imiev-battery-upgrade/imiev-battery-upgrade/cmu/README.md

A cell monitoring unit (CMU) monitors the four batteries in a tray.

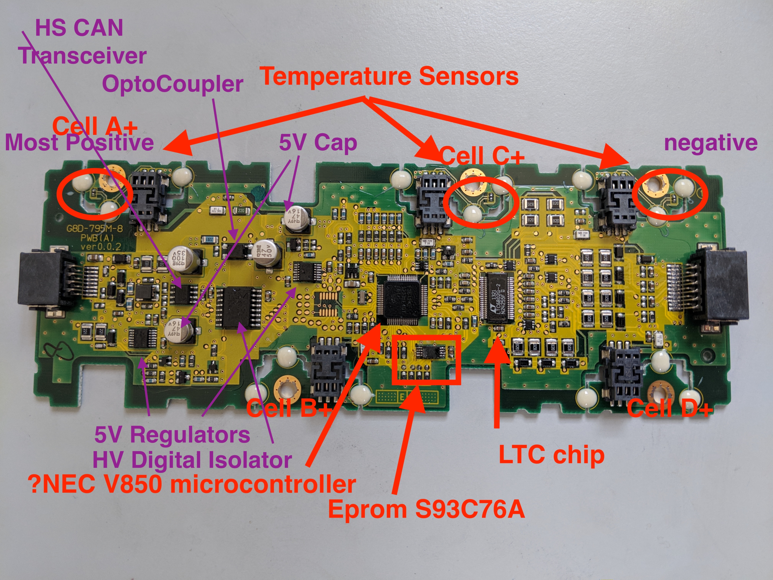
[picture p1: cmu/cmu.jpg]
picture, source: Mário Fernandes (Portugal), through https://www.diyelectriccar.com/threads/mitsubishi-i-miev-cmu-board-notes.200527/
