imiev-battery-upgrade/imiev-battery-upgrade/pack_removal.md

# Pack Removal

The following describes a method to remove and reinstall the i-MiEV's traction battery pack safely and easily without the use of a vehicle lift.

## Procedure

### Vehicle Preparation

1. Lift the vehicle and support it on jack stands.

    See the [SUPPORT LOCATIONS FOR LIFTING AND JACKING](https://web.archive.org/web/20241204221109/http://mmc-manuals.ru/manuals/i-miev/online/Service_Manual/2017/00/html/M100100070122301ENG.HTM) for safe lift and support points.

    In order for the traction battery pack to clear the body, the vehicle must be lifted significantly.

    > [!WARNING]
    > The traction battery pack weighs ~500 pounds. Ensure that the vehicle is well-supported and the jack stands spread widely (both left-right and front-back) so that the car does not shift when removing or installing the pack.

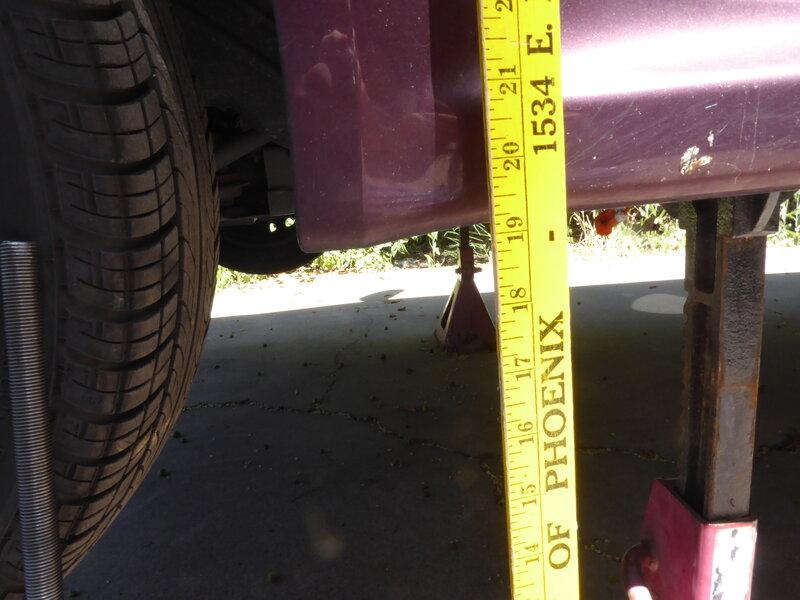
[picture p15: _attachments/P1140324_1751892503863308.JPG]
Vehicle front lifted on jack stands
    

    *Front of vehicle lifted so rocker panel is 19.25" above the ground, which was the limit of the jack stands.*

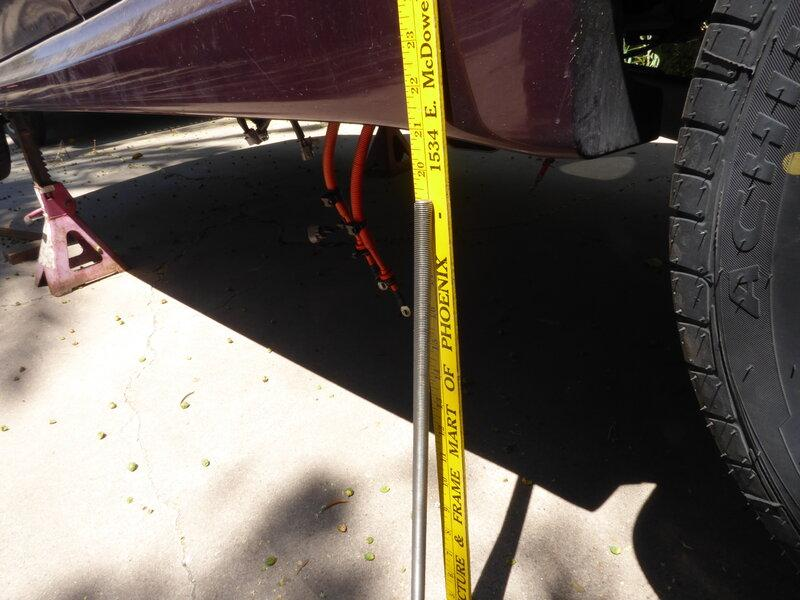
[picture p16: _attachments/P1140330_1751892503868984.JPG]
Vehicle rear lifted on jack stands
    

    *Rear of vehicle lifted so rocker panel is 21" above the ground, which was the limit of the jack stands (supported at rear axle, not shown in photo).*

### Electrical Disconnection

1. Follow the [TRACTION BATTERY REMOVAL AND INSTALLATION](https://web.archive.org/web/20241204221210/http://mmc-manuals.ru/manuals/i-miev/online/Service_Manual/2017/54/html/M154940130021501ENG.HTM) instructions in the service manual to:
    1. Disconnect the 12 volt auxiliary battery.
    2. Disconnect the traction battery pack service plug.
    3. Remove the front and rear traction battery pack splash shields.
    4. Disconnect cables to the traction battery pack.

### Pack Support Installation

1. Remove four of the traction battery pack mounting bolts and replace them with threaded rods and nuts.

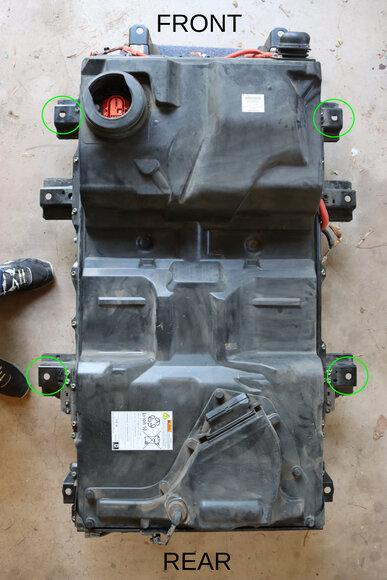
[picture p17: _attachments/pack_bolts_to_remove_1751892503857249.jpg]
Battery pack mounting points
    

    *Remove the four traction battery pack mounting bolts at the circled mount points (shown here from the top with the pack removed).*

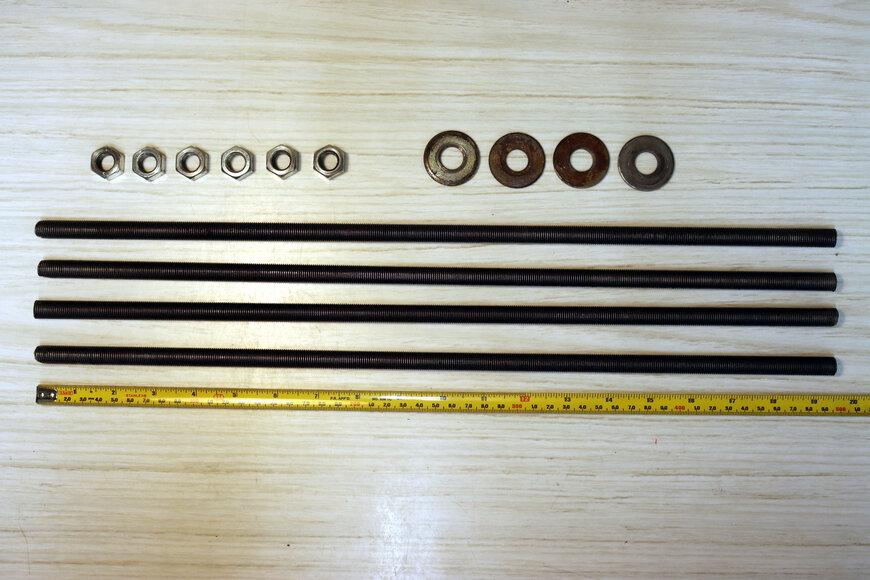
[picture p18: _attachments/threaded_rods_1751892503882977.jpg]
Threaded rods and hardware
    

    *Obtain four [M12-1.25 threaded rods](https://www.clipsandfasteners.com/M12-1-25-x-1-Meter-Threaded-Rod-Class-4-6-Plain-p/bi-v34127.htm) that are approximately 0.5 meters long, a minimum of 6 [M12-1.25 nuts](https://www.clipsandfasteners.com/12mm-1-25-Din-934-Hex-Nut-Zinc-p/a14458.htm), and four fender washers.*

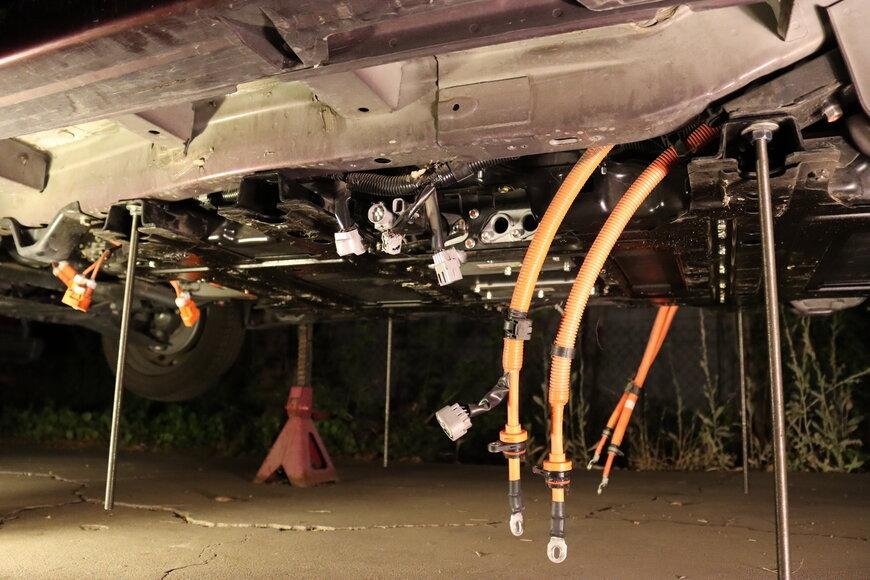
[picture p19: _attachments/IMG_2802_17518925038831842.JPG]
Threaded rod installation
    

    *Replace each of the four removed traction battery pack mounting bolts with a threaded rod, washer, and nut. Ensure the rods are sufficiently threaded into the holes in the body to hold the weight of the pack. Snug the nuts so the threaded rod is supporting the traction battery pack.*

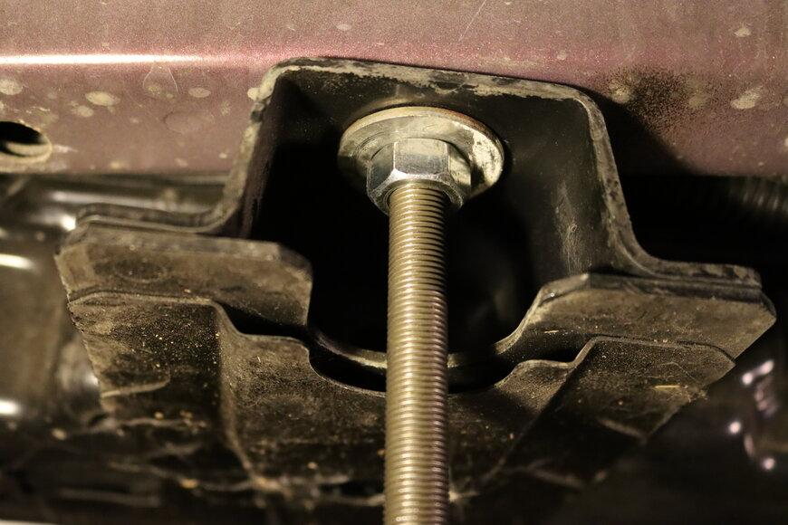
[picture p20: _attachments/IMG_2805_1751892503891283.JPG]
Front mounting point with rod
    

    *Front traction battery pack mounting bolt replaced with threaded rod, washer, and nut.*

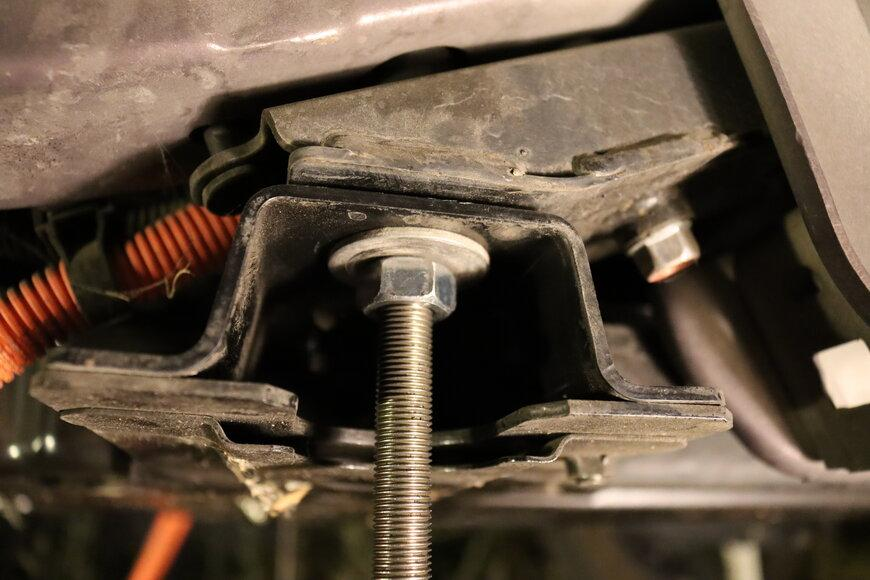
[picture p21: _attachments/IMG_2804_1751892503902833.JPG]
Rear mounting point with rod
    

    *Rear traction battery pack mounting bolt replaced with threaded rod, washer, and nut.*

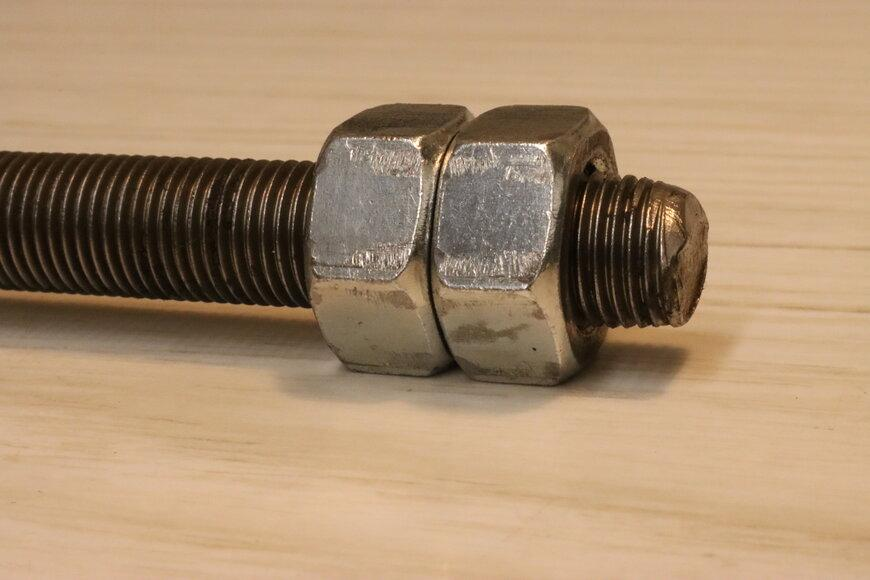
[picture p22: _attachments/IMG_2880_1751892503896538.JPG]
Using locked nuts to install rod
    

    *If the rods can't be hand threaded into the body, two nuts can be locked against each other on the other end of the rod; the locked nuts can then be used to turn the rod into the body with a wrench.*

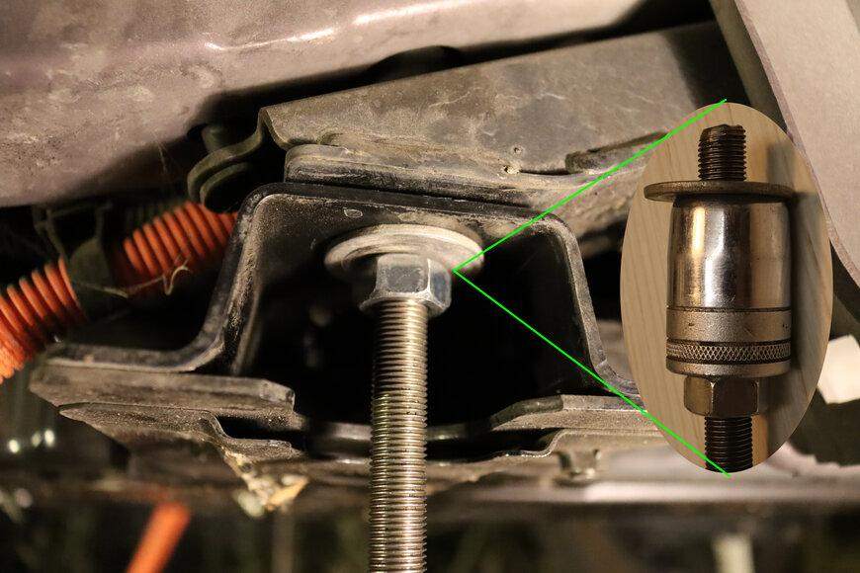
[picture p23: _attachments/spacer_1751892503916682.jpg]
Optional spacer installation
    

    *Optional: Include a spacer between the washer and nut (concept shown in inset using an 1/2 inch drive socket) to move the nut below the box beam. This will make it easier to turn the nut by allowing a wrench to move through a full 360 degrees.*

### Pack Lowering

1. Remove the remaining 6 traction battery pack mounting bolts; the pack will remain in place, supported by the threaded rods and nuts.

2. Lower the pack by loosening the nuts.

    It is recommended to run all four nuts down the rods in small increments to keep the pack approximately level.

    > [!WARNING]
    > Ensure that the rod does not turn and unthread from the body when turning a nut. If the rods can't be held from turning by hand, [lock two nuts](https://5by9.net/prune_batteries/pack_removal.html#lock-two-nuts) against each other and hold with a wrench.

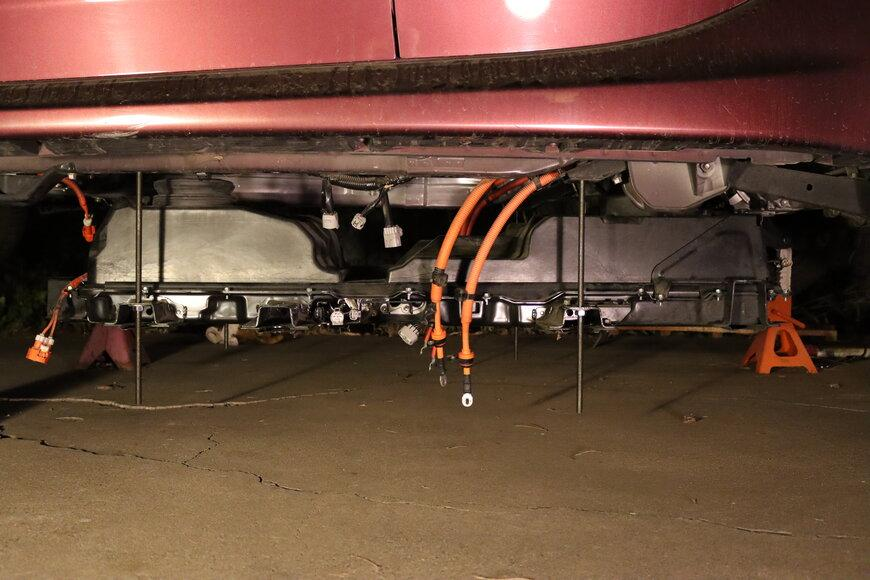
[picture p24: _attachments/IMG_2787_1751892503916571.JPG]
Pack being lowered
    

    *Pack partially lowered. This will be a slow process due to the fine thread on the rods. A ratcheting box wrench is helpful, but still an interference fit with the box beam. If a [spacer was added](https://5by9.net/prune_batteries/pack_removal.html#spacer) in the previous step to lower the nut below the box beam (not shown in photo), a wrench can be turned 360 degrees, which should expedite the process.*

3. Optional: Use a jack to expedite lowering the pack.

    Iteratively supporting the weight of the pack with a jack, spinning down the nuts by hand, and then lowering the pack with the jack to the nuts may be faster.

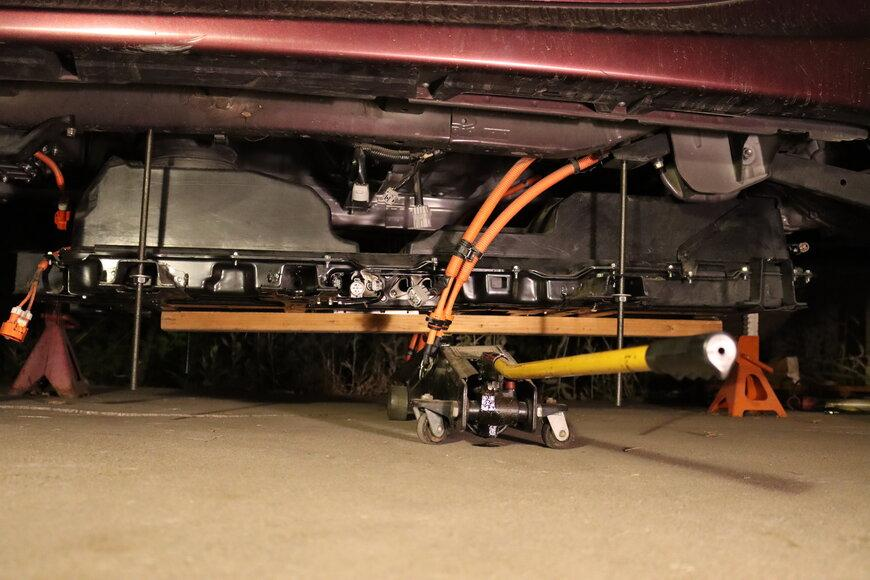
[picture p25: _attachments/IMG_2795_1751892503931233.JPG]
Using jack to assist lowering
    

    *Optional: Use a jack and a 2x4 to slightly lift the pack off the nuts. This allows hand spinning down the nuts, which is much faster than turning the nuts with a wrench under load, while still keeping the descent controlled. It may take several attempts to find the balance point when lifting with the jack (balance point is slightly towards the rear of the pack). Alternatively, multiple jacks can be used to avoid the balancing issue. For a controlled descent, lift the pack off the nuts, spin the nuts down a few inches, lower the pack onto the nuts, and repeat.*

### Final Removal

1. Lower the pack onto dollies.

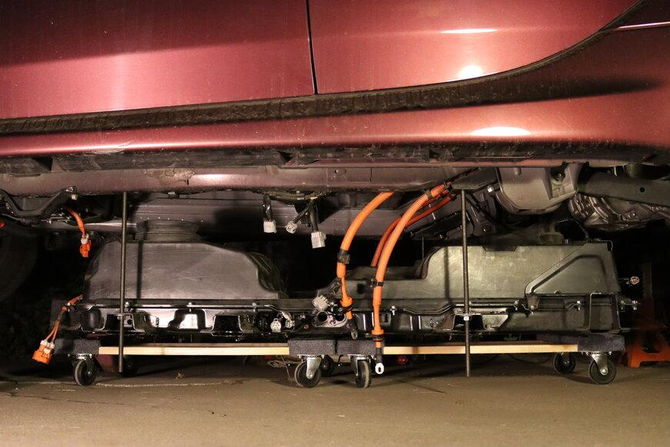
[picture p26: _attachments/IMG_2781_17518925039241128.JPG]
Dollies positioned under pack
    

    *When approaching the height of the dollies, insert them under the pack. Two [Franklin 30 x 18 inch dollies](https://www.harborfreight.com/30-in-x-18-in-1000-lb-capacity-hardwood-dolly-58316.html) were used.*

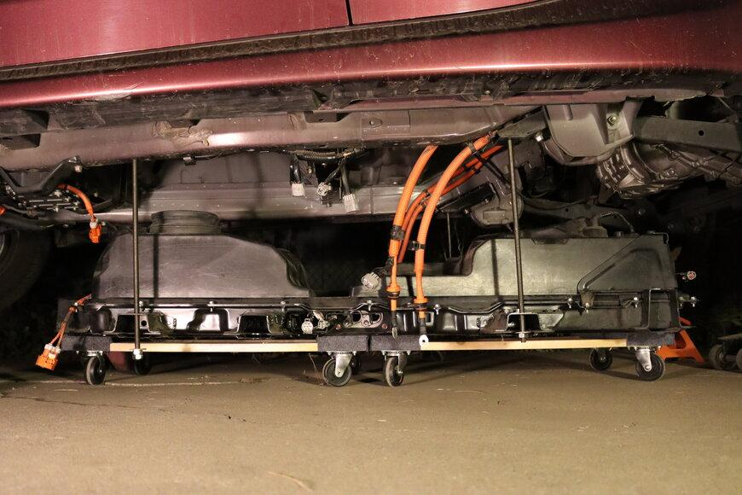
[picture p27: _attachments/IMG_2779_1751892503953265.JPG]
Pack resting on dollies
    

    *Pack resting on dollies. Nuts backed off so the threaded rods are no longer holding any weight.*

2. Remove the rods from the body.

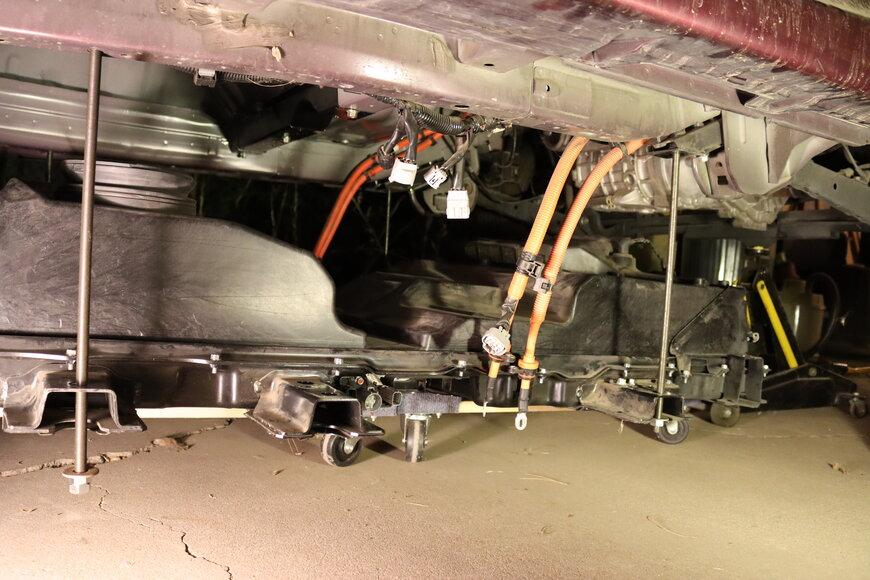
[picture p28: _attachments/IMG_2774_175189250395986.JPG]
Removing rods from body
    

    *Unscrew the rods from the body once they are no longer holding weight.*

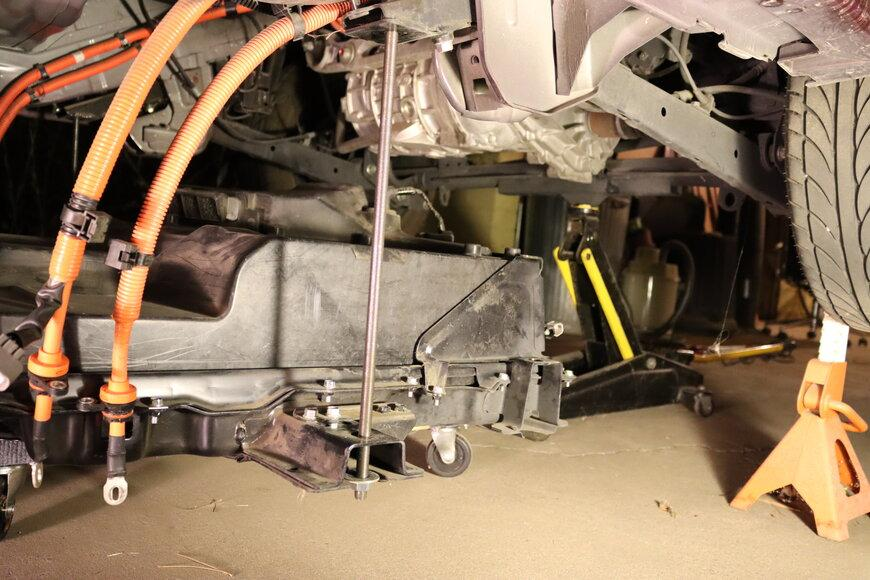
[picture p29: _attachments/IMG_2772_17518925039597812.JPG]
Vehicle lifted for rod clearance
    

    *Depending on the height of the jack stands, height of the dollies, and length of the rods, it may be necessary to temporarily lift the vehicle a small amount to get the clearance to remove the rod. Shown here with rear elevated an inch or two more with the jack.*

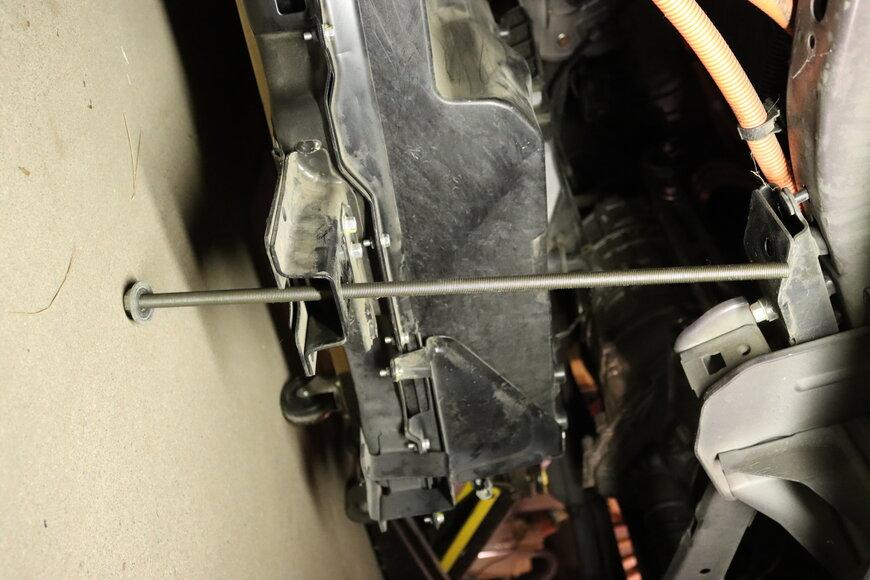
[picture p30: _attachments/IMG_2770_1751892503966368.JPG]
Rear rod removed
    

    *Rear rod removed and vehicle lowered back on to jack stands. It can be seen that the rod was slightly too long to remove without further lifting the vehicle.*

3. Roll the pack out from underneath the vehicle.

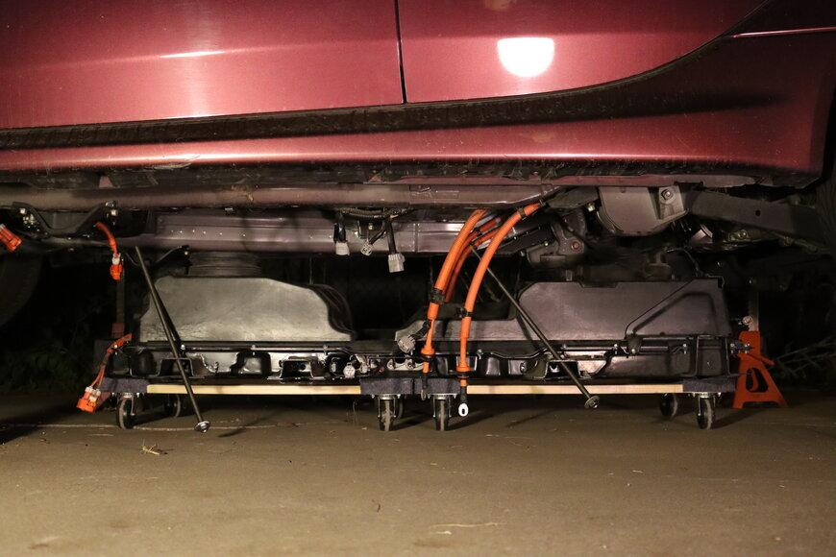
[picture p31: _attachments/IMG_2767_1751892503966452.JPG]
Tilting rods for clearance
    

    *Tilt the rods so they clear the body of the vehicle.*

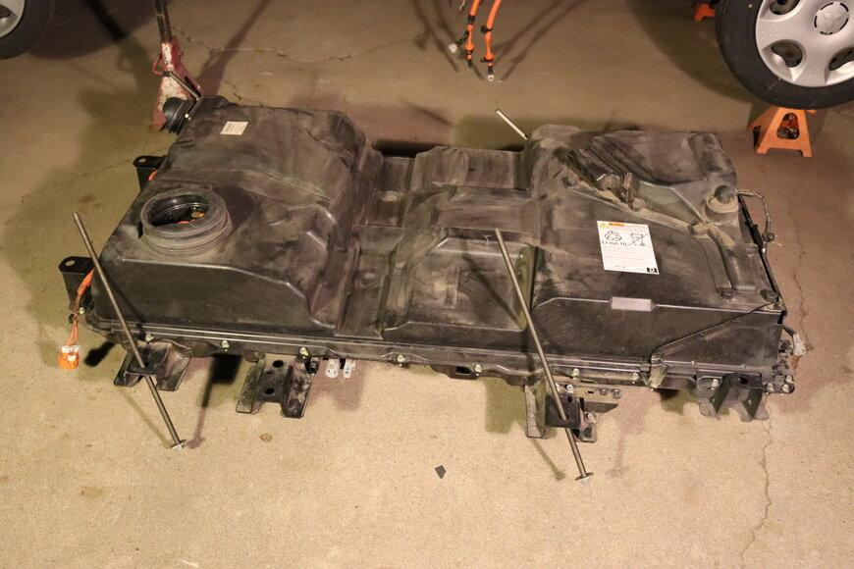
[picture p32: _attachments/IMG_2758_1751892503990935.JPG]
Rolling pack out
    

    *Roll the pack out from underneath the vehicle, watching carefully for interference.*

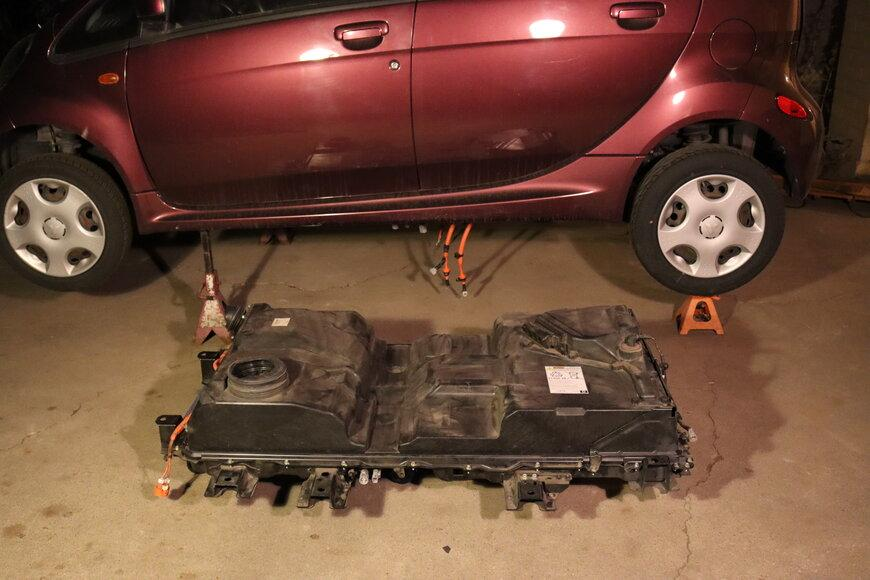
[picture p33: _attachments/IMG_2756_1751892503976146.JPG]
Pack fully removed
    

    *Pack removed.*

### Reinstallation

1. Reinstall the pack by follow the same steps in reverse order.
