imiev-battery-upgrade/imiev-battery-upgrade/glossary.md

# Glossary

- [BMS](https://en.wikipedia.org/wiki/Battery_management_system): battery management system
- [BMU](https://www.redwayess.com/understanding-the-role-of-bmu-in-energy-storage-systems-ess/): the heart of the BMS, in contact with the CAN bus
- [CAN](https://en.wikipedia.org/wiki/CAN_bus) A controller area network is a vehicle bus standard designed for efficient communication primarily between electronic control units.
- [CMU](https://archive.is/ERbzV): cell monitoring unit, reports to the battery management system
- [DTC](https://en.wikipedia.org/wiki/Diagnostic_Trouble_Code): diagnostic trouble code
- [ECU](https://en.wikipedia.org/wiki/Electronic_control_unit): electric control unit, [embedded system](https://en.wikipedia.org/wiki/Embedded_system) in [automotive electronics](https://en.wikipedia.org/wiki/Automotive_electronics) that controls one or more of the [electrical systems](https://en.wikipedia.org/wiki/Automotive_electronics#Types) or subsystems in a car
- [ETACS](http://mitsipedia.info/index.php?title=ETACS): Electronic Total Automotive Control System, the hub for all the vehicle's electronic functions, using CAN an LIN bus
  - [see also](https://gearshifters.org/mitsubishi/what-is-etacs-mitsubishi/)
- [EVSE](https://en.wikipedia.org/wiki/Charging_station) charging station
- FSM: factory service manual, [1](http://mmc-manuals.ru/manuals/i-miev/online/Service_Manual/2017/index_M1.htm), [2](https://jdmfsm.info/Auto/Japan/Mitsubishi/i-MiEV/Manuals/)
- GOM: GuessOMeter, rough indication of the range left
- Lexia 3 diagbox: cheap diagnostic tool for Peugeot/Citroën, "all" authorised dealer tool capabilities
- [MUT III](https://web.archive.org/web/20240630100905/https://mitsubishitechinfo.com/epacarb/ver_30_NAS_M.U.T.3MANUAL.pdf): Mitsubishi dealer diagnostic tool, "multi use tester"
- [OBC](https://en.wikipedia.org/wiki/Charging_station): on board charger, the vehicle's builtin AC-> DC converter that helps charge the high voltage battery
- [SoC](https://en.wikipedia.org/wiki/State_of_charge): battery state of charge, electric equivalent of a fuel gauge; in %
- [SoH](https://en.wikipedia.org/wiki/State_of_health): battery state of health, compared to its ideal conditions/specifications; in %
- [TPMS](https://en.wikipedia.org/wiki/Tire-pressure_monitoring_system): tire pressure monitoring system
- VCI: vehicle communication interface, the connector hardware part of the Mitsubishi MUT III system; see also MUT III
