imiev-battery-upgrade/imiev-battery-upgrade/module_rebuild.md

# i-MiEV: Fitting 94ah NMC Batteries in the Pack

This guide shows how an i-MiEV pack was rebuilt, replacing the 50ah LEV50s with [94ah NMC batteries](https://www.alibaba.com/product-detail/Brand-New-CATL-Ternary-Lithium-Ion_1600494889608.html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).

Challenges: The 94ah NMC batteries have a slightly different form factor and terminals that must be adapted to fit in the pack.

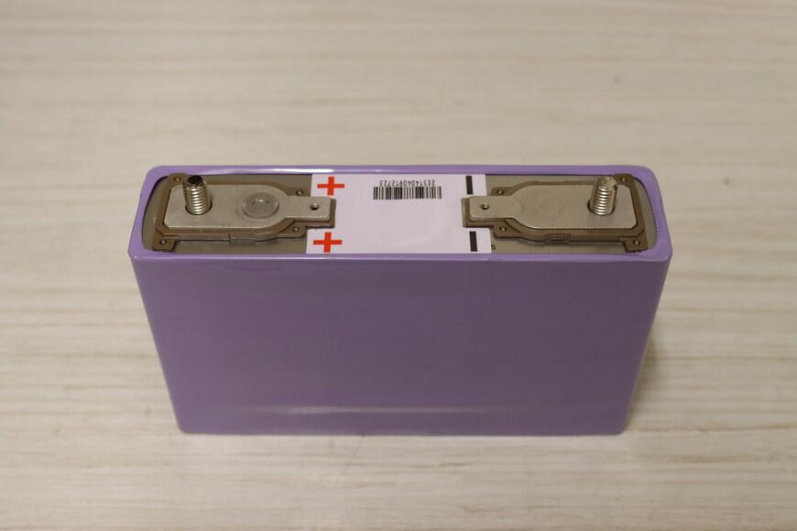
[picture p34: _attachments/IMG_2531_1751892503984215.JPG]
Old LEV50 battery


*Old 50ah LEV50.*

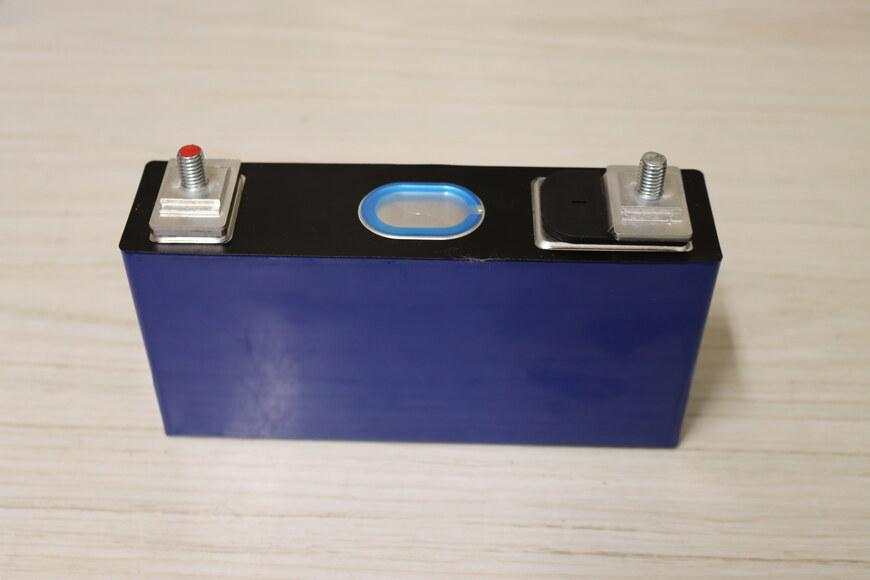
[picture p35: _attachments/IMG_2535_1751892503980072.JPG]
New NMC battery with M8 terminals


*New 94ah NMC. Note the M8 terminals (custom ordered instead of the default M6) to match the LEV50.*

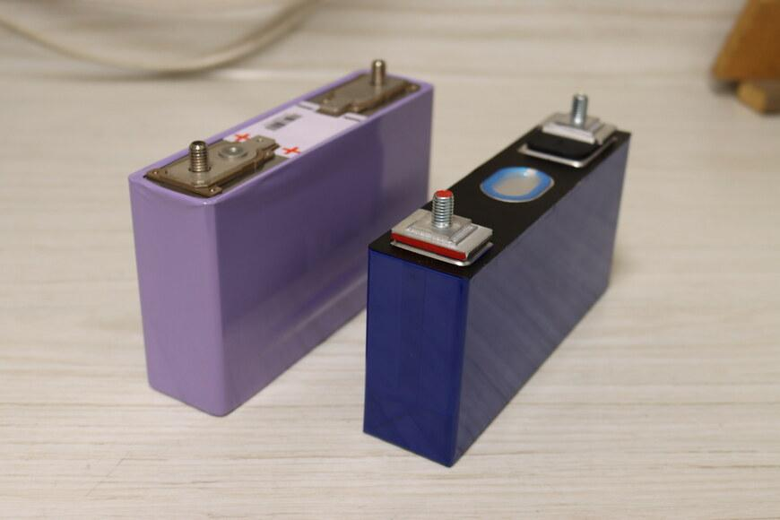
[picture p36: _attachments/IMG_2536_17518925039985049.JPG]
Battery size comparison


*The LEV50 (left) and NMC (right) have slightly different form factors. The NMC is slightly narrower than the LEV50.*

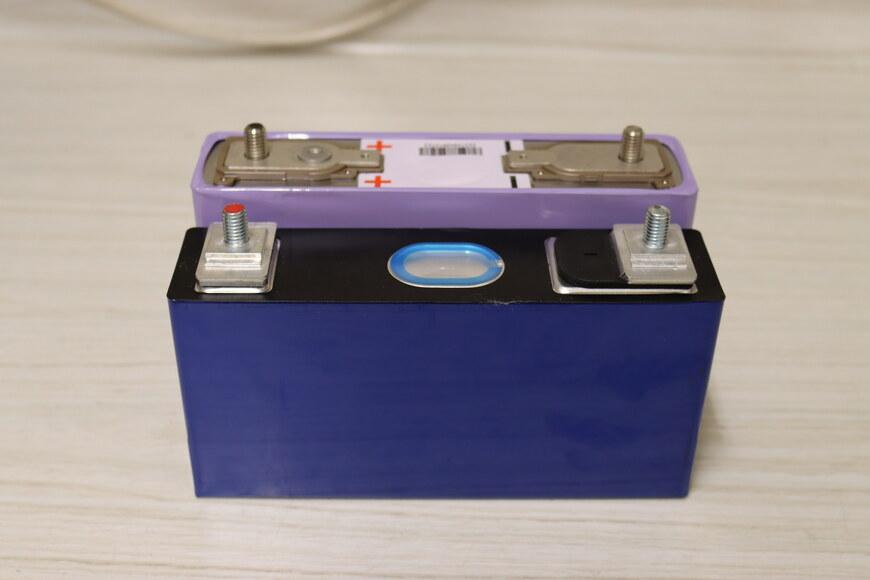
[picture p37: _attachments/IMG_2537_1751892504002529.JPG]
Height comparison of batteries


*The NMC (foreground) is shorter than the LEV50 (background).*

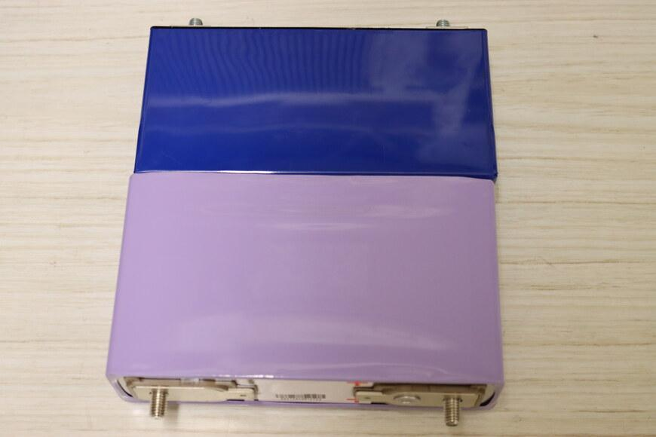
[picture p38: _attachments/IMG_2539_17518925040066292.JPG]
Length comparison of batteries


*The NMC (top) is slightly longer than the LEV50 (bottom).*

## Procedure

> [!WARNING]
> The pack contains high voltages and high current sources that may result in property damage, serious injury, or death. Adhere to the [PRECAUTIONS ON HOW TO USE THE HIGH-VOLTAGE VEHICLE](https://web.archive.org/web/20241222211352/http://mmc-manuals.ru/manuals/i-miev/online/Service_Manual/2017/54/html/M154940710001501ENG.HTM) and other safety recommendations in the [service manual](https://web.archive.org/web/20241223155351/http://mmc-manuals.ru/manuals/i-miev/online/Service_Manual/2017/index_M1.htm). Do not attempt the upgrade procedure if not trained/qualified, experienced, and comfortable working with high voltage, high current systems.

### Initial Disassembly

1. See the [service manual](https://web.archive.org/web/20241223155351/http://mmc-manuals.ru/manuals/i-miev/online/Service_Manual/2017/index_M1.htm) for instructions on removing and opening the pack

    The pack consists of ten 8-cell modules and two 4-cell modules. An 8-cell module consists of two 4-cell modules. For this document, these will be referred to as modules (8 cells) and submodules (4 cells).

    It is recommended to reinstall each rebuilt module in the same location from which it was removed in the pack. This avoids potentially needing to reprogram the BMU due to moving the CMUs. Consider numbering the modules and submodules before removal, or only removing and rebuilding a single module at a time, to ensure the modules are reinstalled in the same location from which they were removed in the pack.

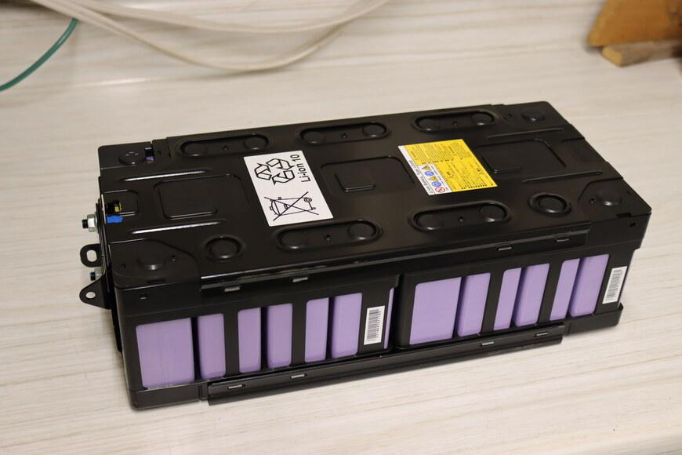
[picture p39: _attachments/IMG_2528_1751892504011963.JPG]
8-cell battery module
    

    *An 8-cell module removed from the pack.*

2. It is recommended to mark the positioning of the positive terminals before opening the module. This will ease assembly and reduce the chance of making a polarity error that might destroy the CMUs.

    A paint pen or nail polish work well for marking the positive ends.

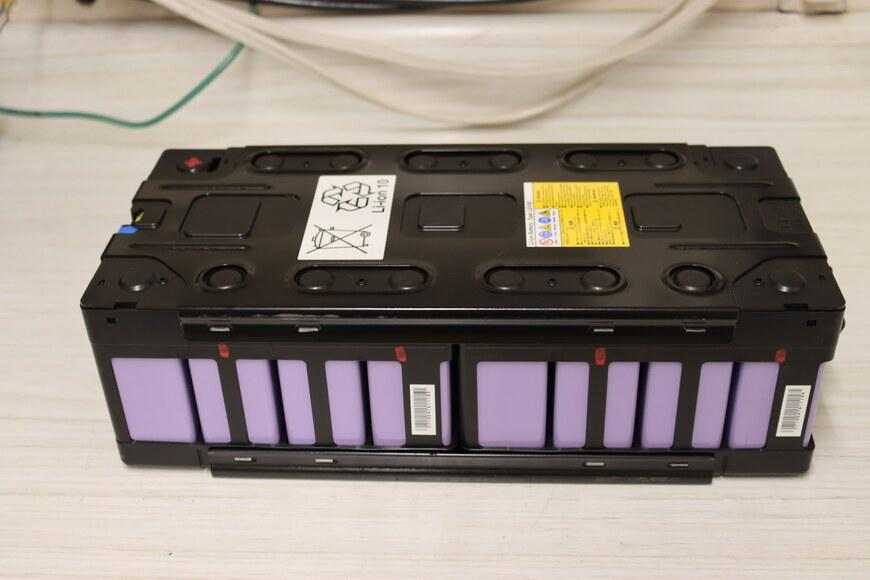
[picture p40: _attachments/IMG_2554_1751892504019211.JPG]
Marked battery terminals
    

    *Positive ends of cells marked before further disassembly.*

3. Remove the mounting brackets holding the metal clam shell together.

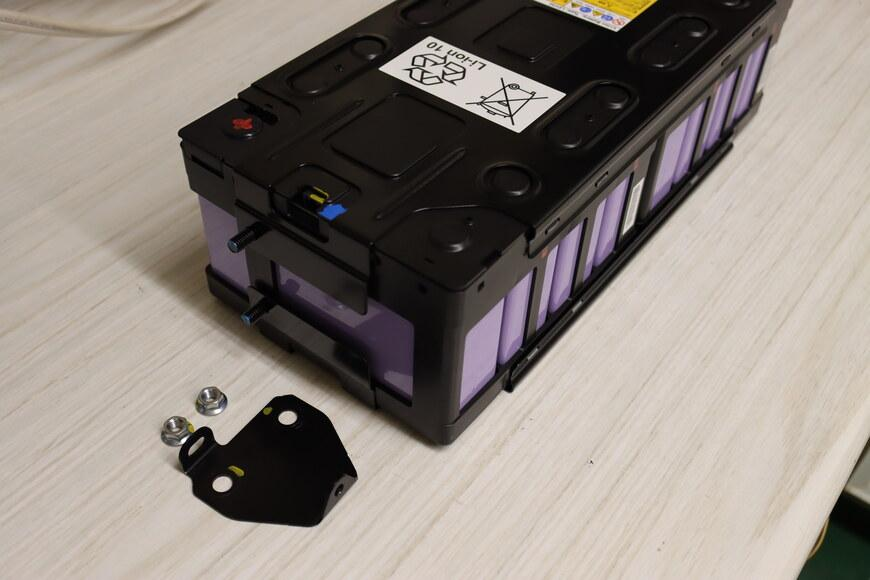
[picture p41: _attachments/IMG_2557_1751892504024575.JPG]
Left mounting bracket removed
    

    *Left bracket (connector side) removed.*

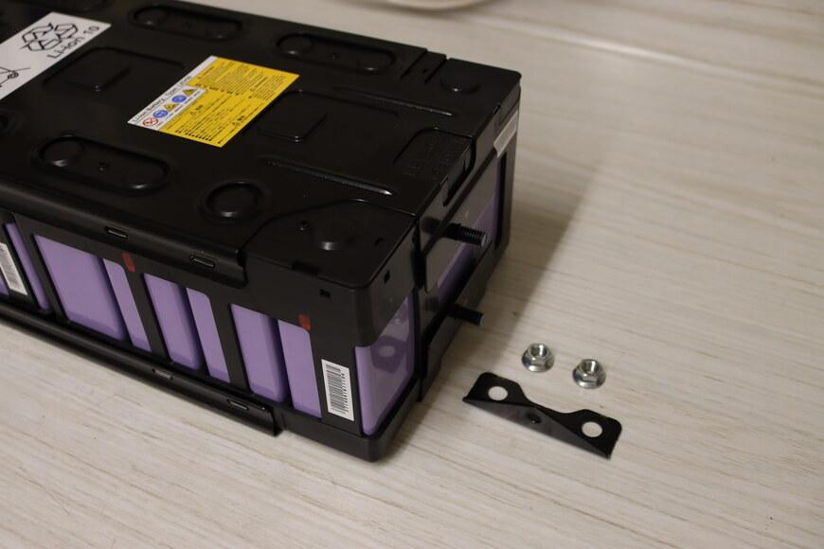
[picture p42: _attachments/IMG_2558_1751892504034296.JPG]
Right mounting bracket removed
    

    *Right bracket removed.*

4. Remove the top metal clam shell by prying it over the 8 plastic tabs.

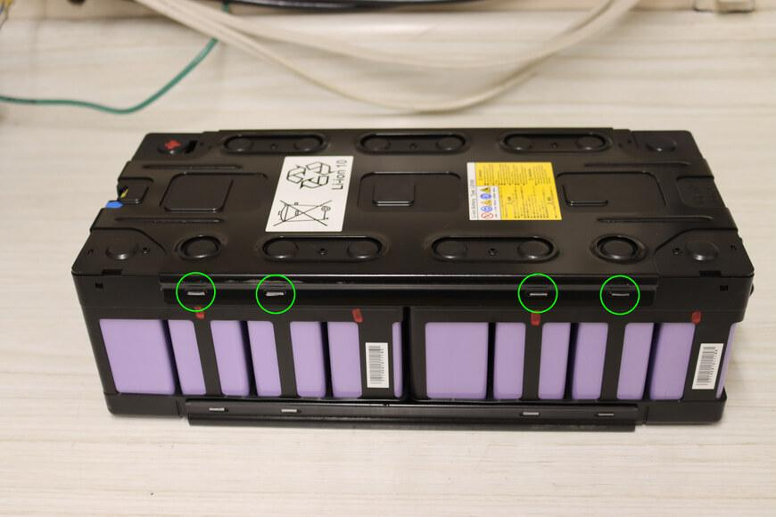
[picture p43: _attachments/clam_shell_tabs_1751892504029442.jpg]
Plastic tabs on clam shell
    

    *Plastic tabs holding on the metal clam shell.*

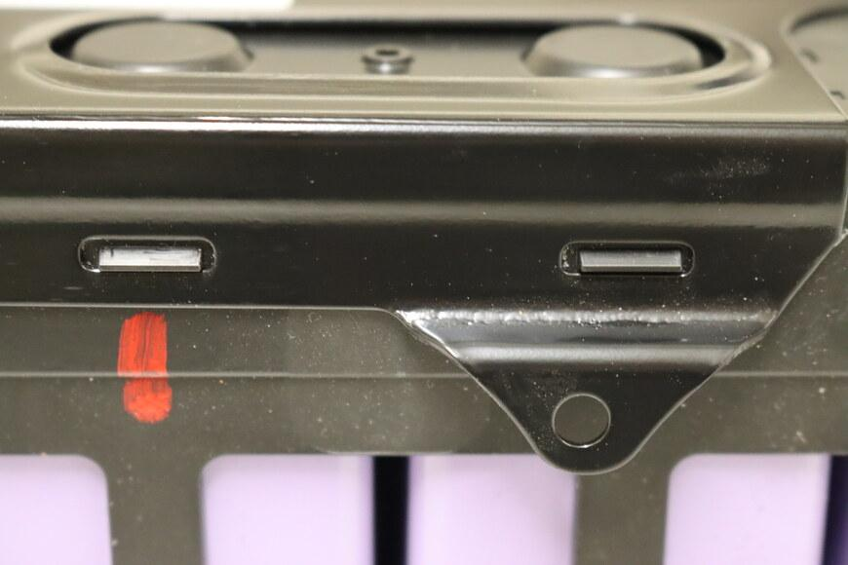
[picture p44: _attachments/IMG_2707_1751892504041951.JPG]
Close up of plastic tabs
    

    *Close up of two of the tabs.*

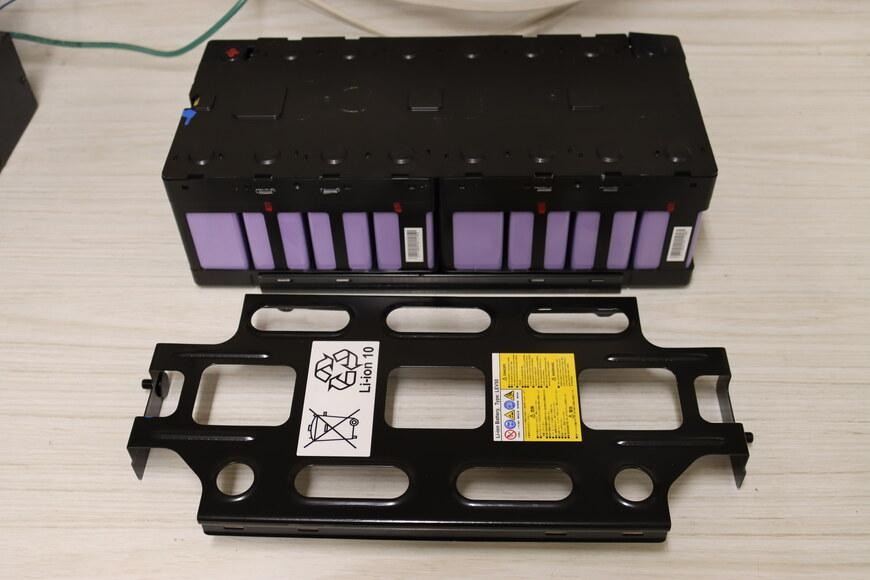
[picture p45: _attachments/IMG_2560_175189250405269.JPG]
Top clam shell removed
    

    *Top metal clam shell removed.*

5. Pry off the plastic top cover, which is held on by tabs.

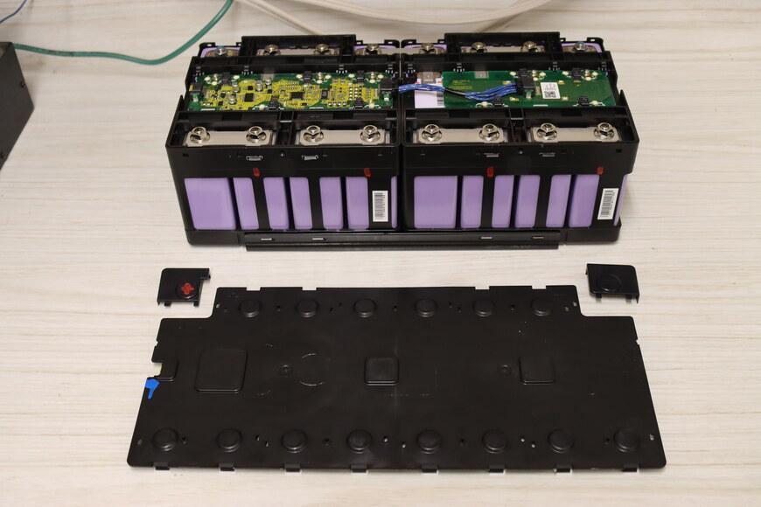
[picture p46: _attachments/IMG_2561_1751892504047725.JPG]
Plastic cover removed
    

    *Plastic cover removed.*

6. Remove the cable between the CMU and daughter board.

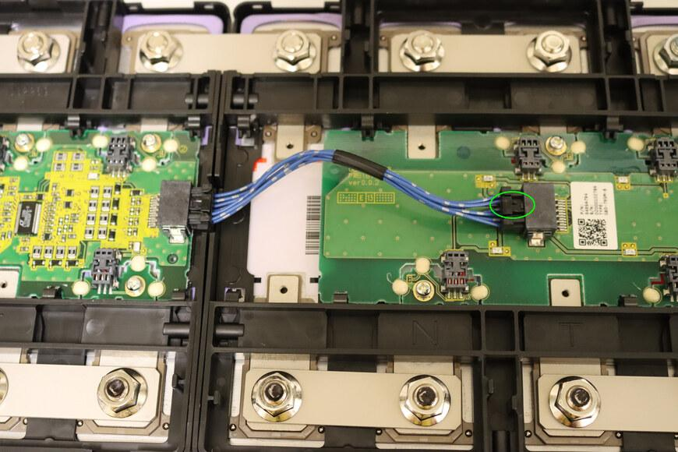
[picture p47: _attachments/daughter_board_cable_1751892504059765.jpg]
CMU cable connection
    

    *Cable between the CMU and daughter board. Depress the tab (circled) to separate the plug from the socket. Repeat on the other end.*

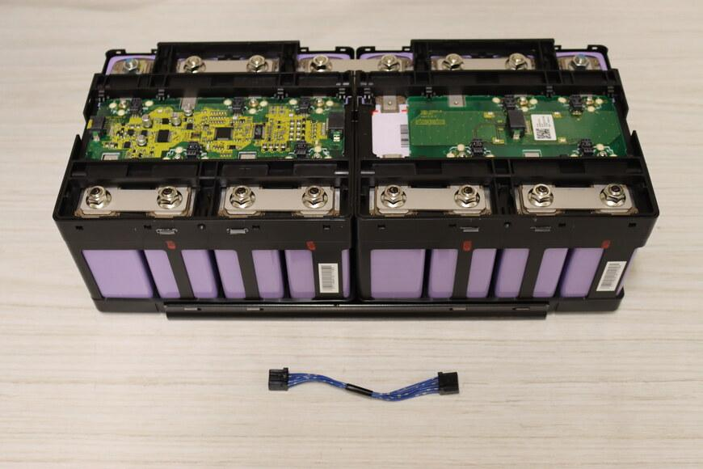
[picture p48: _attachments/IMG_2563_1751892504068529.JPG]
CMU cable removed
    

    *Cable removed.*

7. Remove the bus bar between the two submodules.

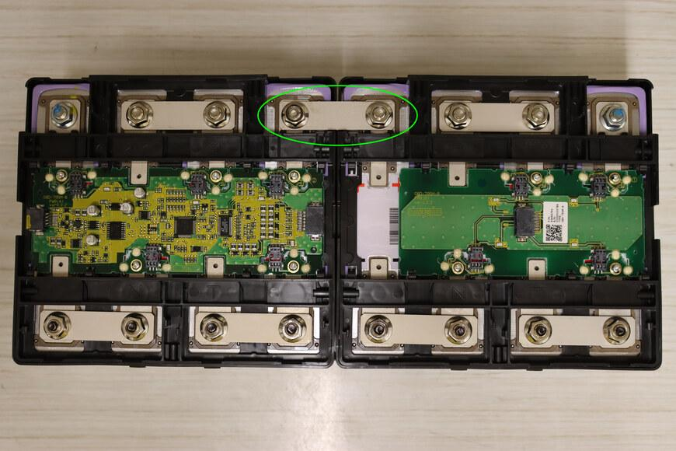
[picture p49: _attachments/bus_bar_linking_modules_1751892504087863.jpg]
Bus bar connecting submodules
    

    *Remove the bus bar linking the two submodules.*

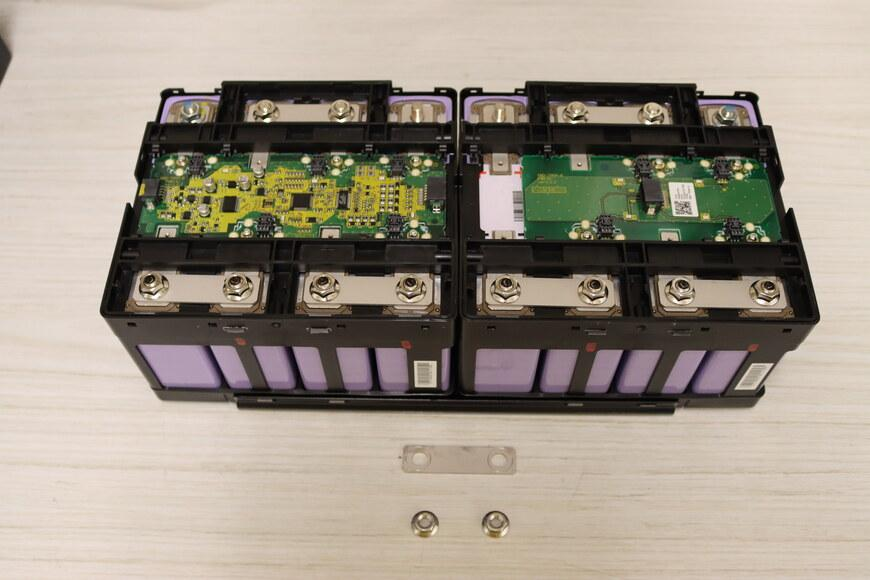
[picture p50: _attachments/IMG_2566_1751892504075469.JPG]
Bus bar removed from submodules
    

    *Bus bar removed.*

8. Remove the bottom metal clam shell by prying it over the 8 plastic tabs.

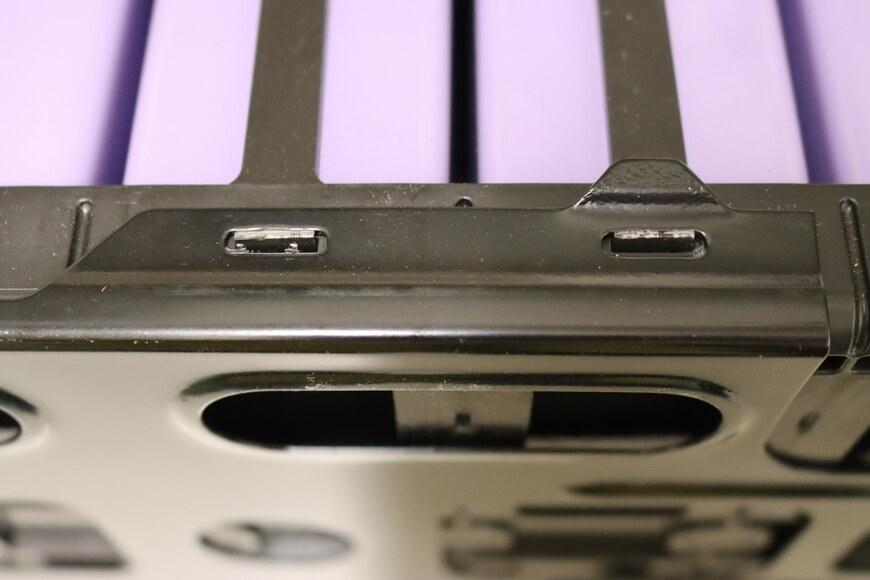
[picture p51: _attachments/IMG_2569_1751892504092445.JPG]
Bottom clam shell plastic tabs
    

    *Plastic tabs holding on the metal clam shell.*

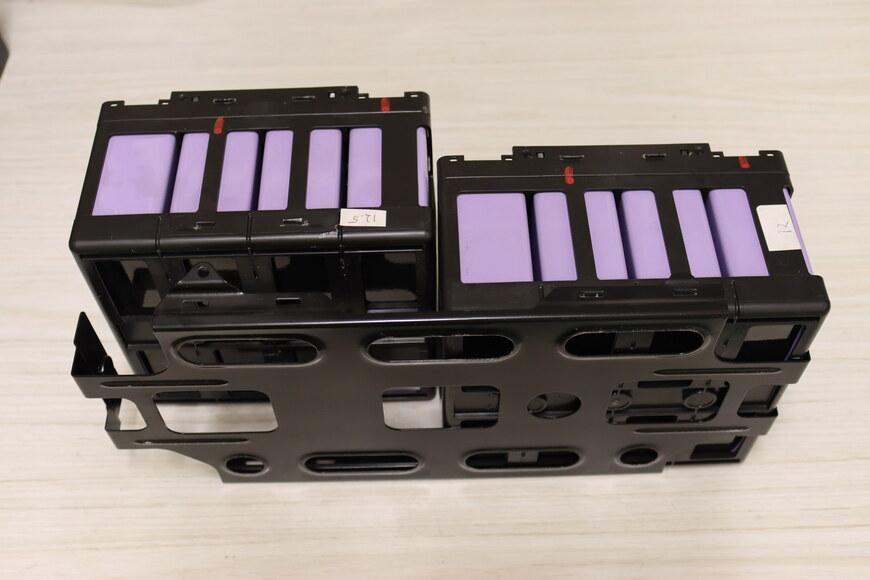
[picture p52: _attachments/IMG_2567_175189250408759.JPG]
Module on side for removal
    

    *It may be helpful to place the module on its side to free the battery cage from the clam shell so as not to be fighting against gravity.*

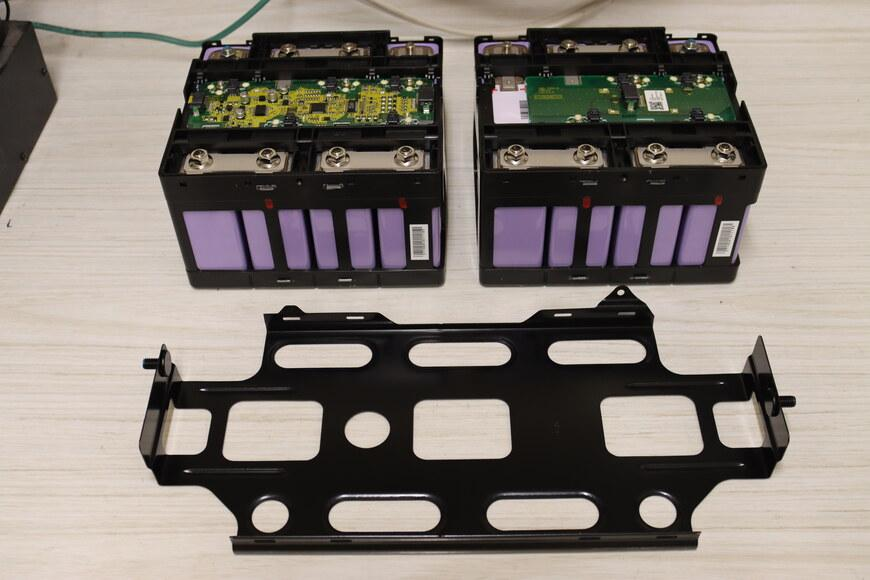
[picture p53: _attachments/IMG_2571_1751892504120824.JPG]
Bottom clam shell removed
    

    *Bottom clam shell removed.*

### CMU and Battery Removal

1. Remove the 4 screws attaching the CMU daughter board to the batteries.

    > [!WARNING]
    > The circuit board is delicate. By comparison, the batteries have great mass. The reason for removing the screws now is so that any movement/shiftage of the batteries during disassembly doesn't result in a force that is transferred to and breaks the circuit board.

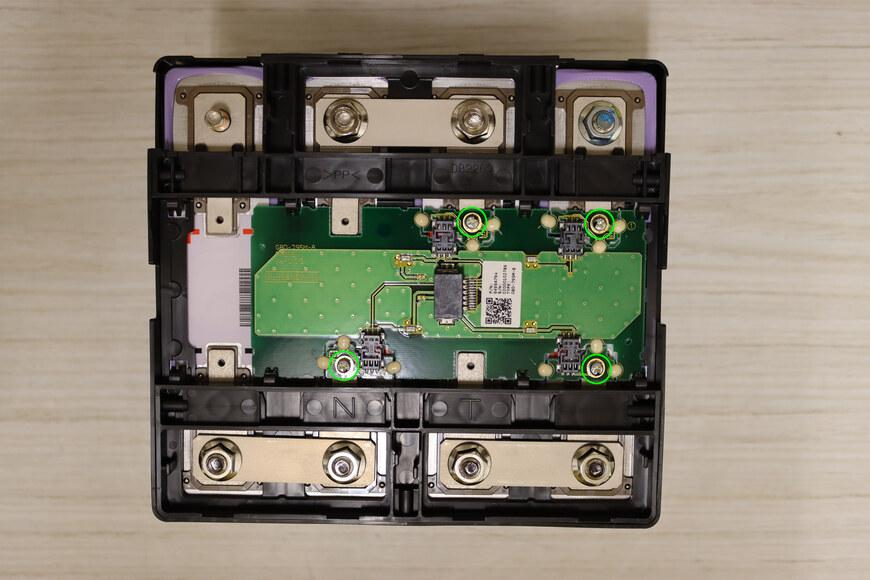
[picture p54: _attachments/daughter_board_screws_removing_1751892504109699.jpg]
CMU daughter board screw locations
    

    *Remove the four circled screws.*

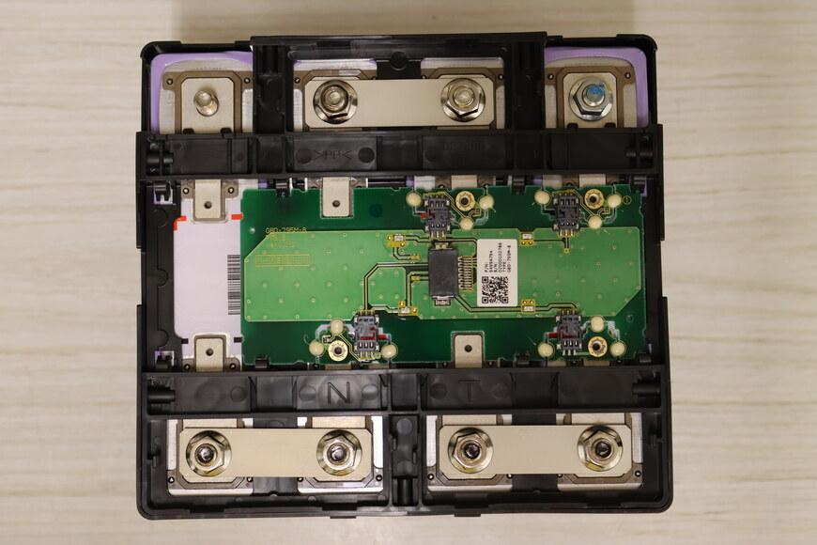
[picture p55: _attachments/IMG_2576_17518925041209202.JPG]
CMU screws removed
    

    *Screws removed.*

2. Remove the top webbing of the battery cage.

    Note that there is adhesive at the circular points. Care must be taken to avoid breaking the plastic when severing the adhesive.

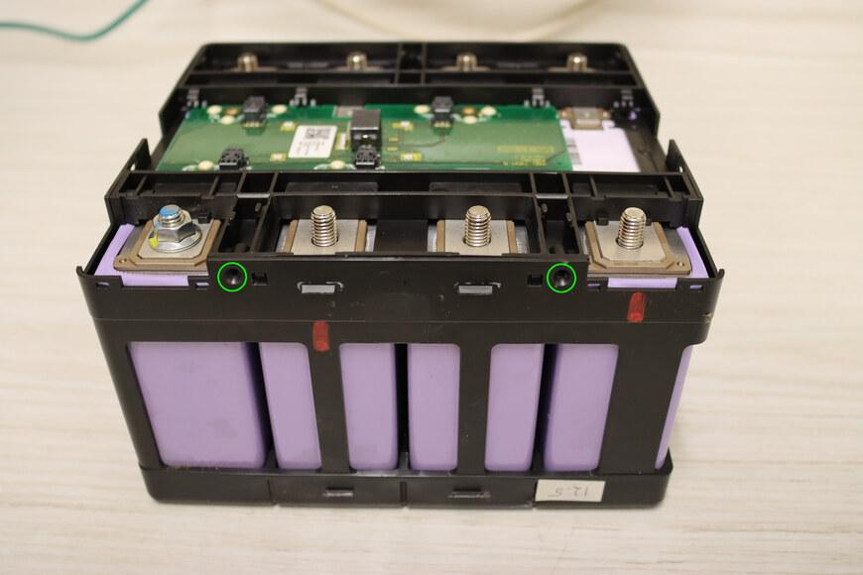
[picture p56: _attachments/cage_top_webbing_adhesive_175189250410412.jpg]
Adhesive points on webbing
    

    *There is adhesive at the circular points.*

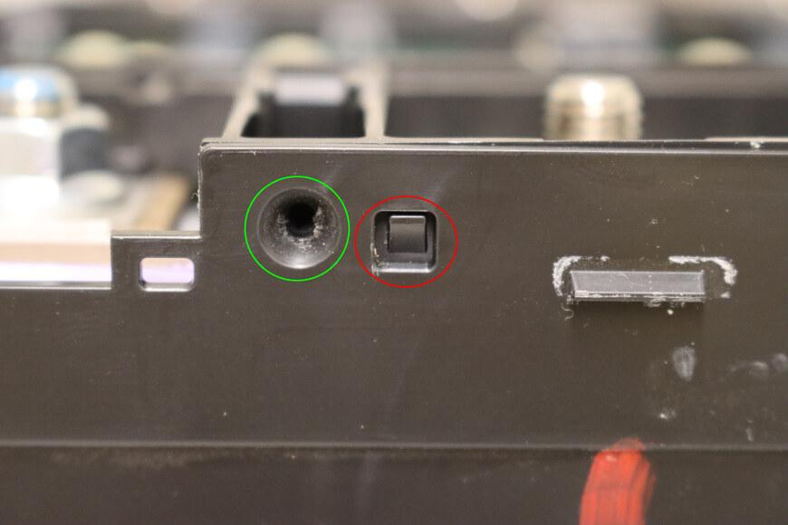
[picture p57: _attachments/cage_top_webbing_locator_tab_17518925041330938.jpg]
Webbing locator tab detail
    

    *Care must be taken when slicing the adhesive at the circular points (green circle) not to sever the nearby locating tab (red circle).*

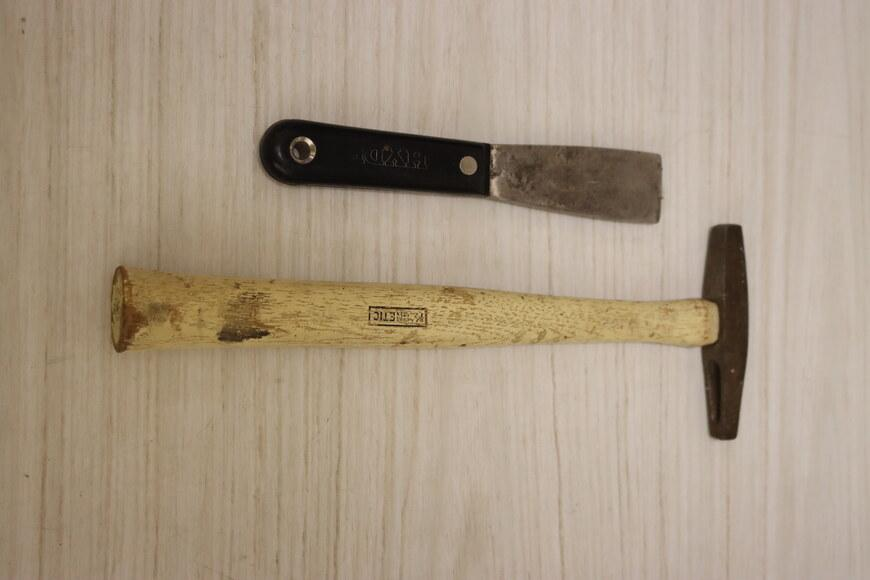
[picture p58: _attachments/IMG_2580_1751892504128587.JPG]
Using putty knife to cut adhesive
    

    *A putty knife with light tapping can be used to cut the adhesive without breaking the plastic.*

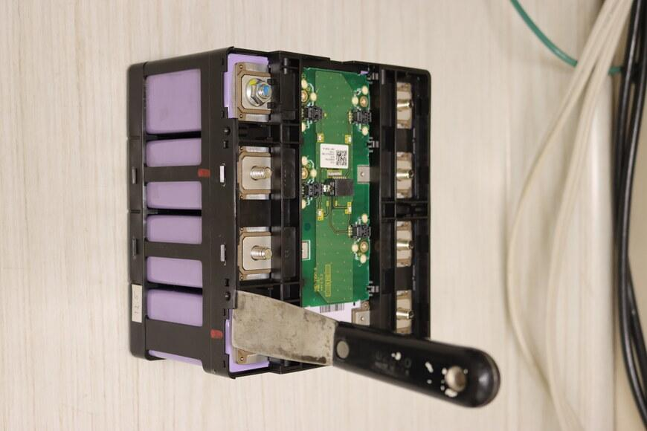
[picture p59: _attachments/IMG_2581_1751892504138564.JPG]
Putty knife between plastic pieces
    

    *Wedge the putty knife between the two pieces of plastic at an adhesion point. Gently tap the putty knife to cut the adhesive. Repeat for the remaining 6 (total 7) adhesion points*

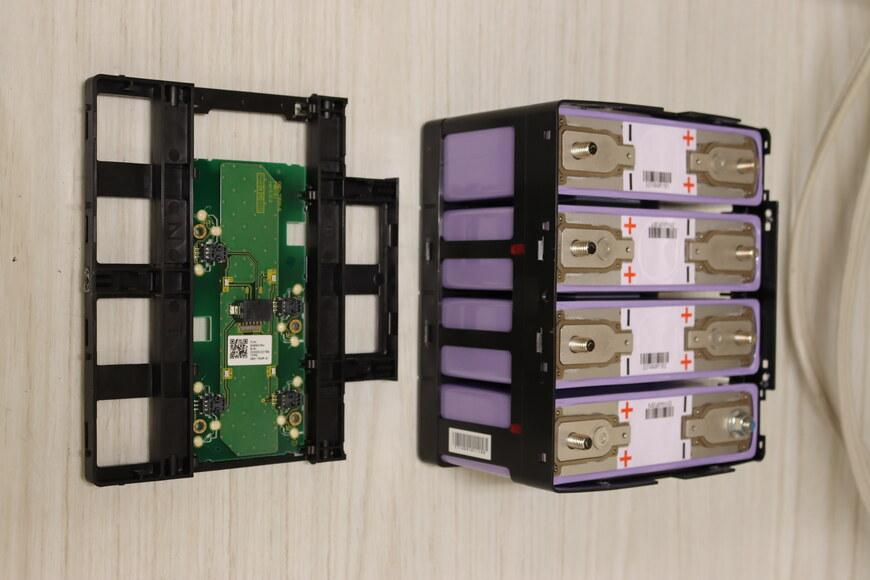
[picture p60: _attachments/IMG_2585_1751892504144211.JPG]
Top webbing removed
    

    *Remove the top webbing, which is now only held on by plastic tabs.*

3. Remove the batteries from the cage.

    Push the cells out from the bottom. The batteries are a very tight fit and it will take some force. Tape and rubber spacers between the batteries mean all four batteries will likely move as an unit.

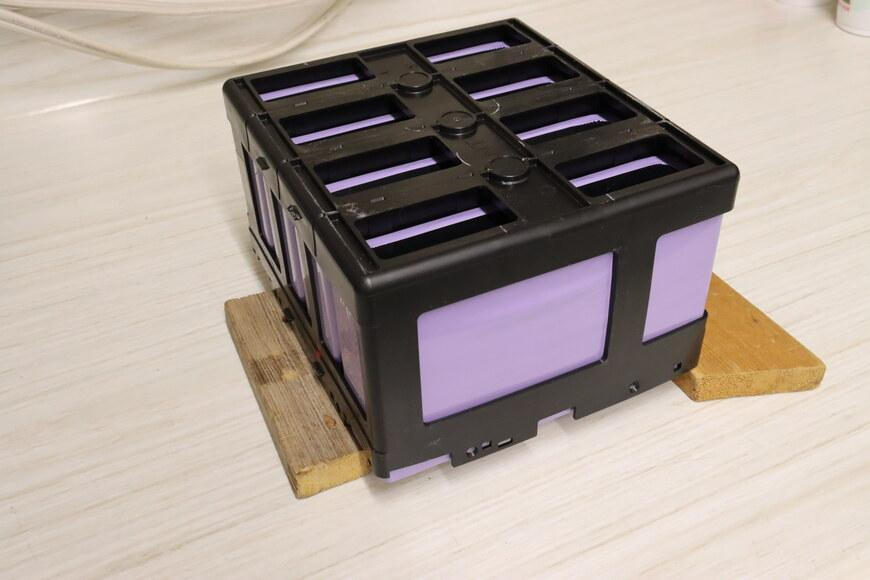
[picture p61: _attachments/IMG_2662_1751892504149281.JPG]
Flipping cage to remove batteries
    

    *To start the batteries moving, it may be helpful to flip the cage upside down, block up the edges of the cage, and push the bottom of the batteries down.*

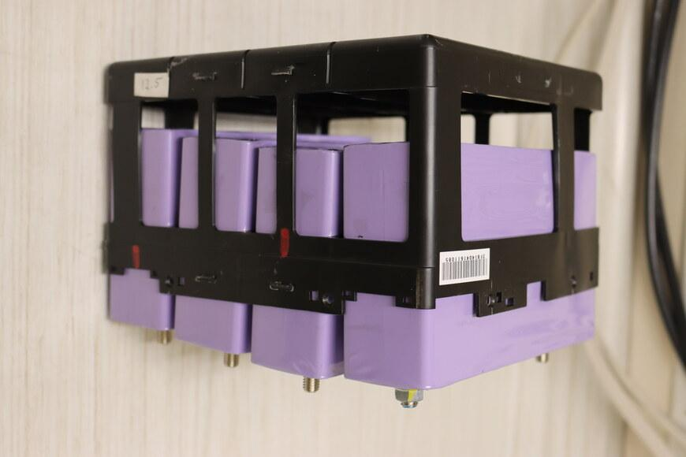
[picture p62: _attachments/IMG_2586_175189250415579.JPG]
Batteries moving as unit
    

    *The high coefficient of friction on the rubber spacers means the batteries will likely move as an unit.*

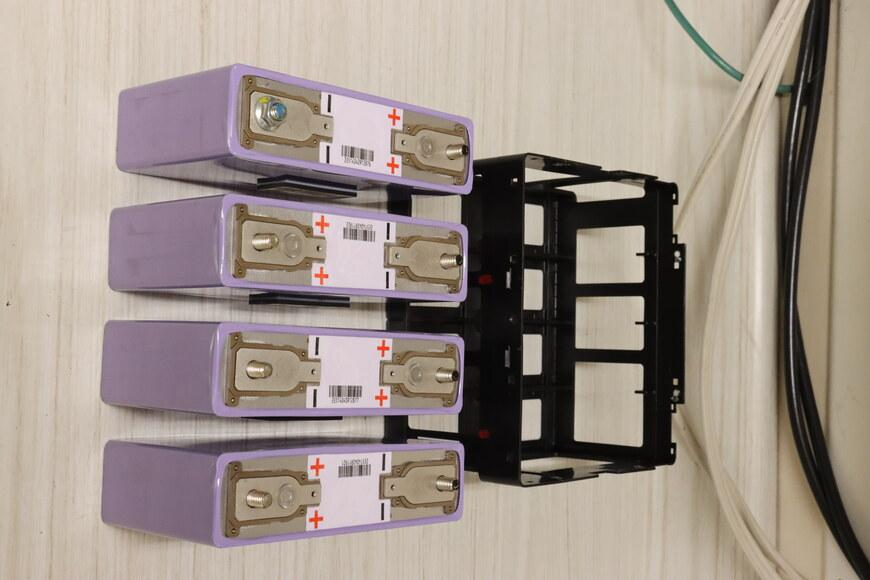
[picture p63: _attachments/IMG_2588_1751892504166367.JPG]
All batteries removed
    

    *Batteries removed.*

### Battery Cage Preparation

1. Mark the polarity on the inside of the battery cage. This will ease in reassembly and reduce the probability of an error.

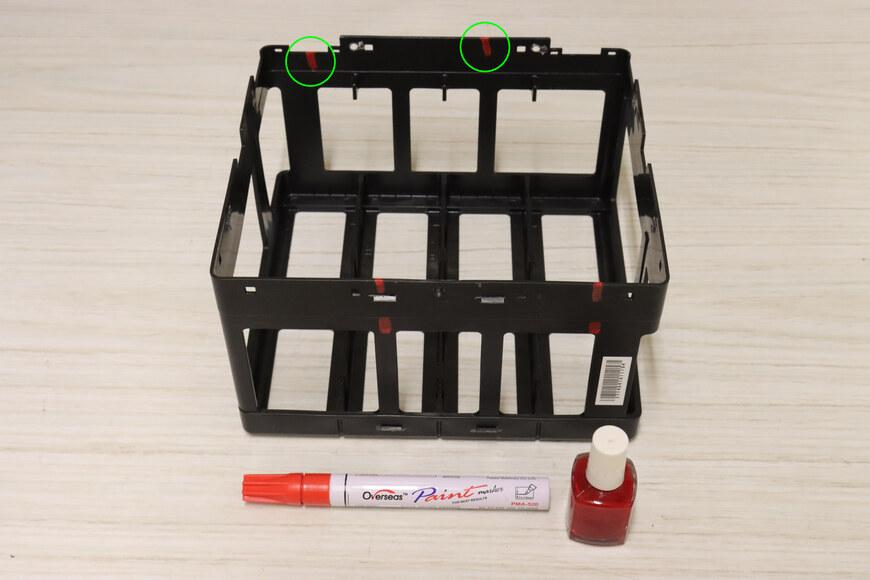
[picture p64: _attachments/battery_cage_polarity_inside_17518925041765819.jpg]
Battery cage polarity markings
    

    *Extend the polarity marks on the outside of the battery cage to the inside.*

2. Mark the polarity on the new batteries. This will ease in reassembly and reduce the probability of an error.

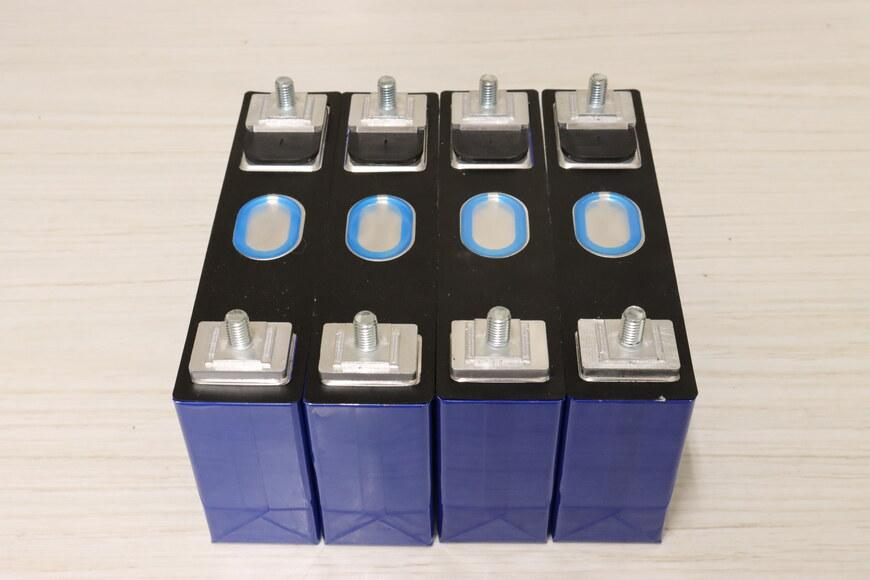
[picture p65: _attachments/IMG_2669_1751892504160884.JPG]
Unmarked battery terminals
    

    *Polarity is not well-marked on the new terminals.*

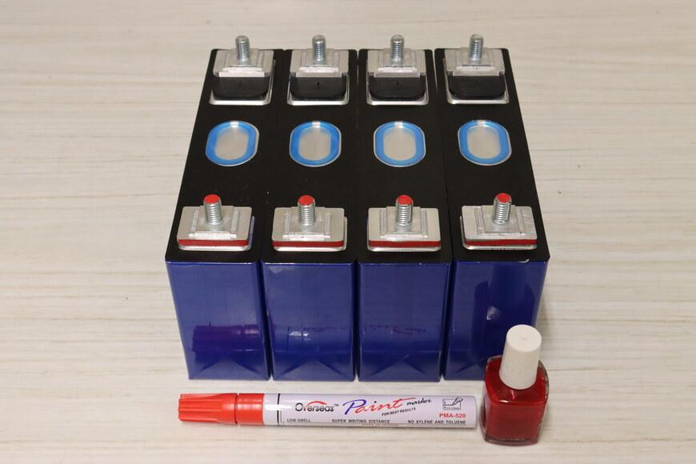
[picture p66: _attachments/IMG_2670_1751892504171788.JPG]
Marking battery polarity
    

    *A paint pen or nail polish work well for marking the polarity.*

3. Remove ~2mm on each side of the battery cage base to accommodate the slightly longer, NMC batteries.

    A snug fit is OK, as the batteries shouldn't rattle around. Too tight and there is danger of breaking the plastic cage or tearing the outer insulation of the battery when inserting.

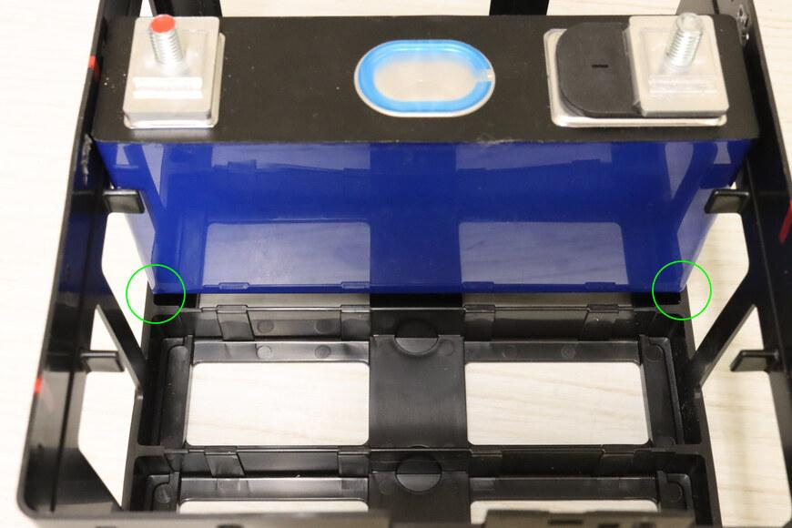
[picture p67: _attachments/battery_cage_battery_length_17518925041825511.jpg]
Battery length comparison
    

    *The new NMC batteries are slightly longer and don't fit in the base of the battery cage.*

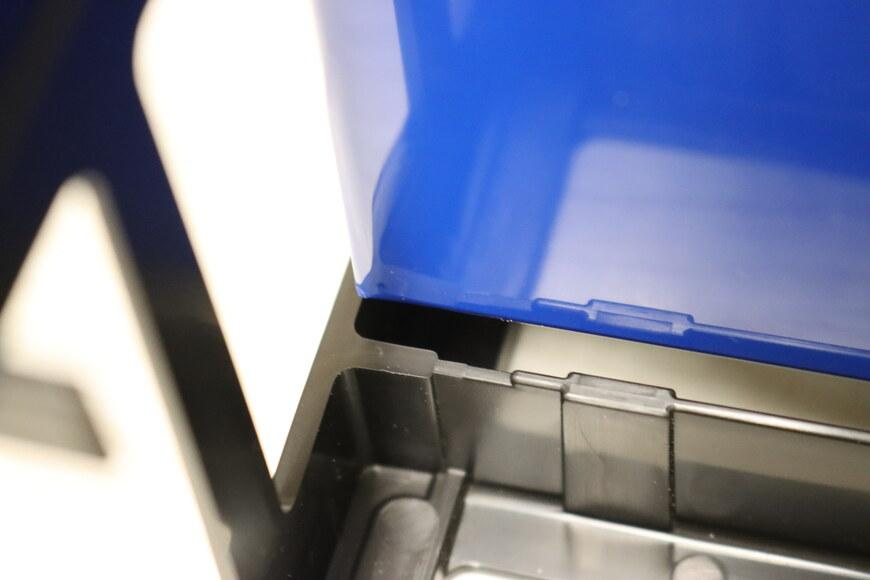
[picture p68: _attachments/IMG_2594_17518925041920269.JPG]
Left side battery overhang
    

    *Battery overhang on left.*

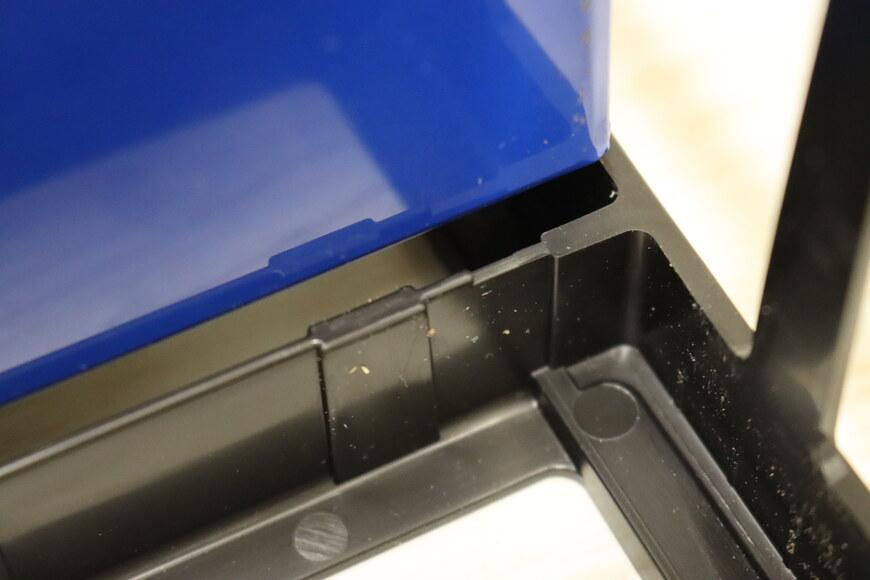
[picture p69: _attachments/IMG_2595_17518925041874182.JPG]
Right side battery overhang
    

    *Battery overhang on right.*

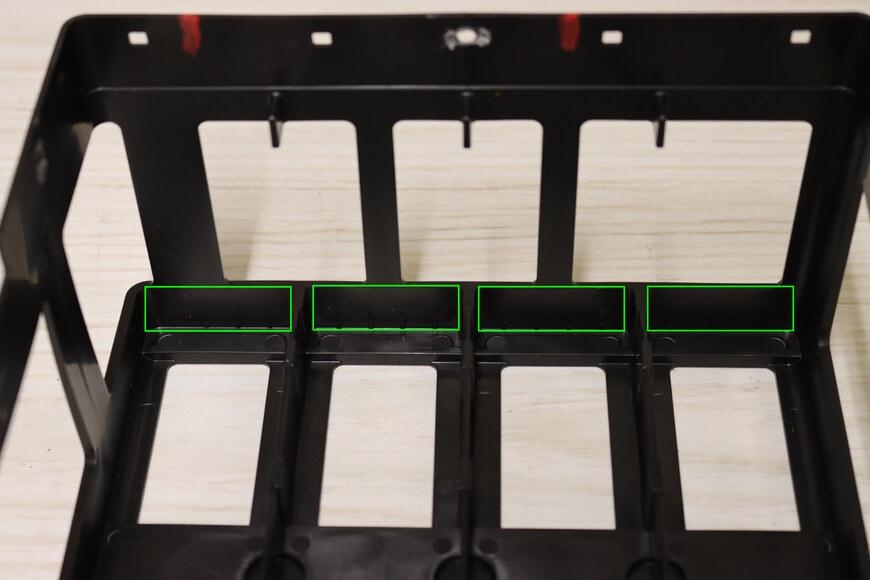
[picture p70: _attachments/battery_cage_bottom_1751892504202508.jpg]
Material removal area
    

    *Material removal area.*

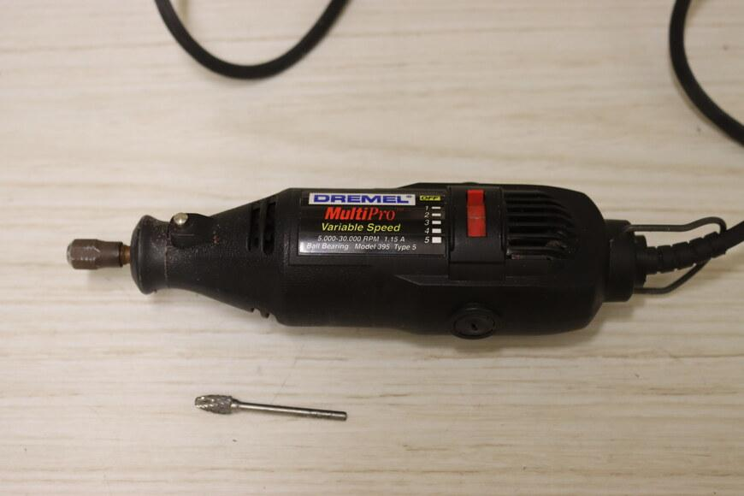
[picture p71: _attachments/IMG_2607_17518925041974761.JPG]
A Dremel or rotary tool with a deburring bit can be used to remove the material
    

    *A Dremel or rotary tool with a deburring bit can be used to remove the material.*

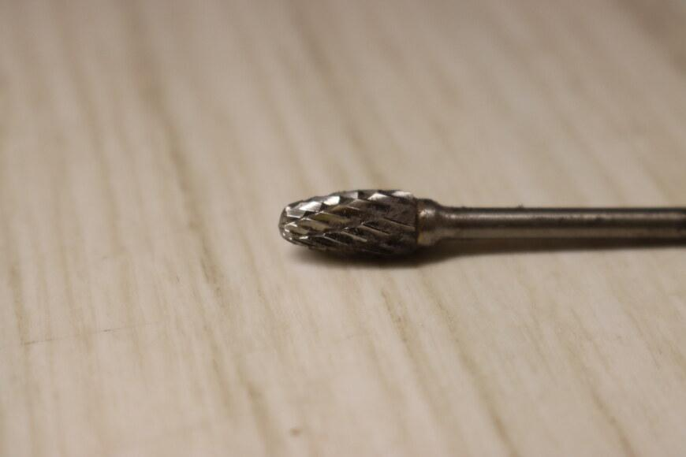
[picture p72: _attachments/IMG_2611_1751892504206351.JPG]
Deburring bit
    

    *Deburring bit.*

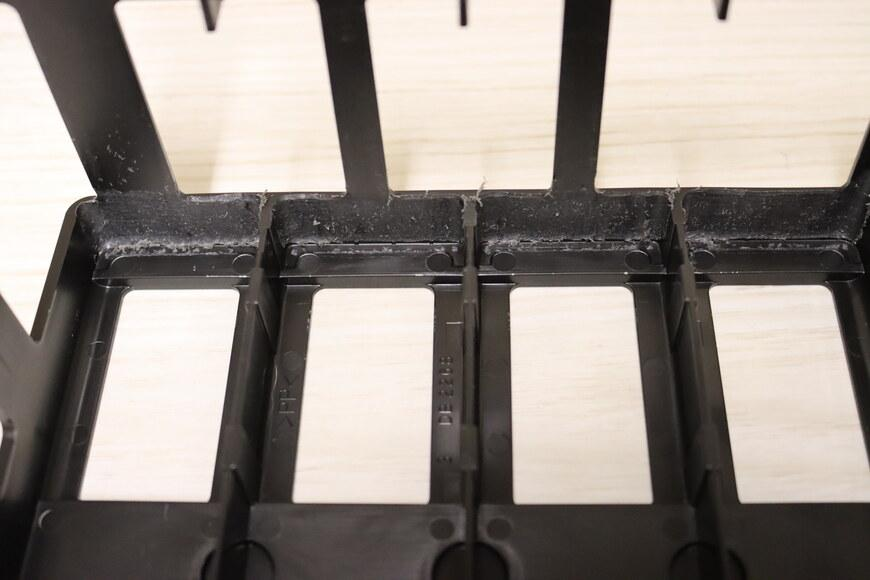
[picture p73: _attachments/IMG_2612_1751892504211755.JPG]
1-2mm of material removed. Repeat on the opposite side
    

    *1-2mm of material removed. Repeat on the opposite side.*

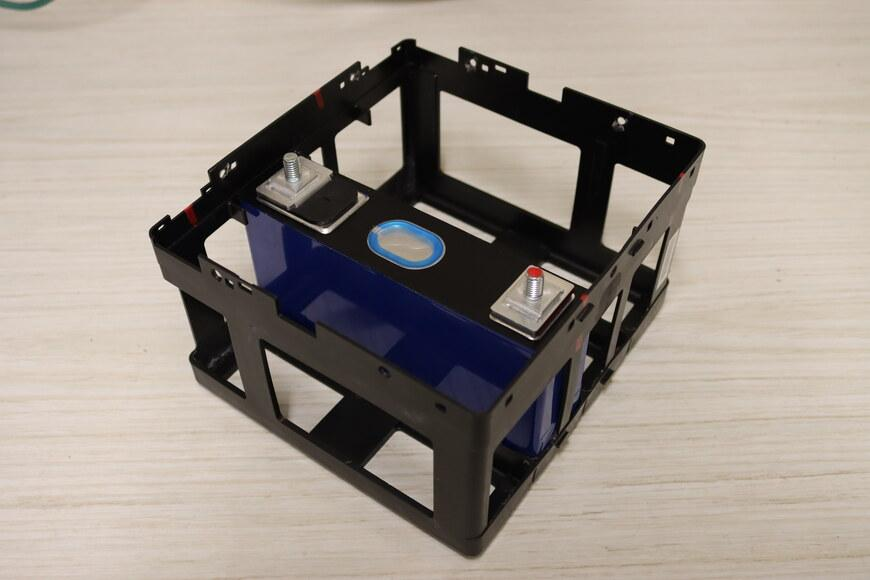
[picture p74: _attachments/IMG_2618_175189250421683.JPG]
Test fit
    

    *Test fit.*

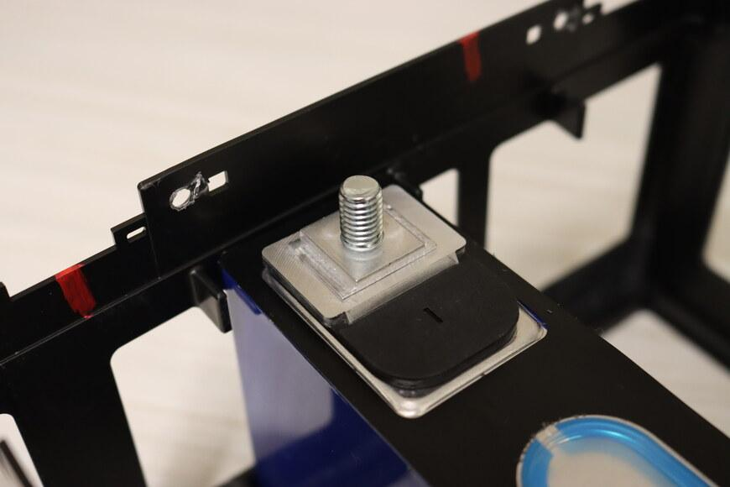
[picture p75: _attachments/IMG_2619_1751892504222469.JPG]
Note the top of the battery lines up with a top line on the battery cage
    

    *Note the top of the battery lines up with a top line on the battery cage.*

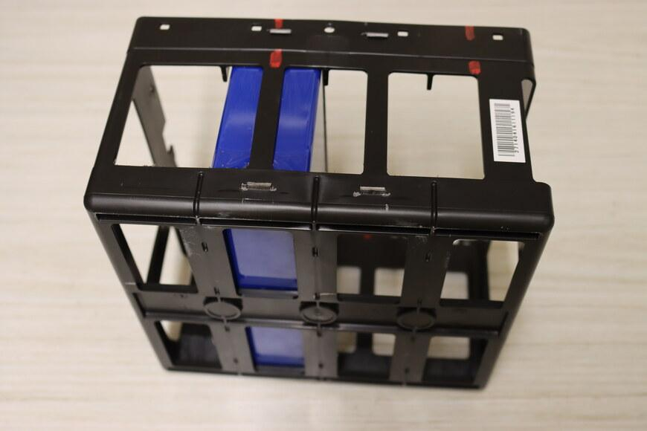
[picture p76: _attachments/IMG_2622_1751892504230002.JPG]
Flip the battery cage over and verify that the battery fully inserts to the bottom of the cage
    

    *Flip the battery cage over and verify that the battery fully inserts to the bottom of the cage.*

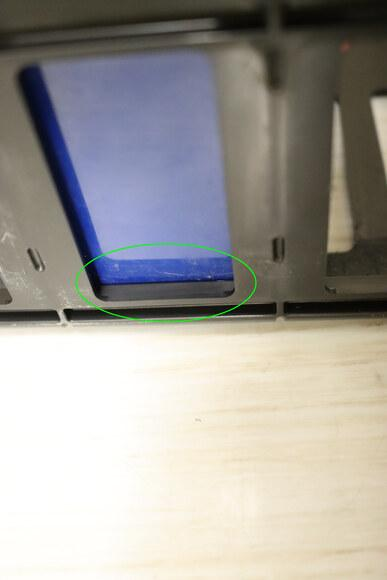
[picture p77: _attachments/battery_cage_battery_seated_17518925042247272.jpg]
Battery seated with no space between the bottom of the battery and the cage
    

    *Battery seated with no space between the bottom of the battery and the cage.*

4. Add spacers to the bottom of the battery cage to elevate the new, shorter batteries 4mm.

    > [!TIP]
    > Corrugated plastic is available in 4mm thickness and has some other nice properties: easy to cut, allows air circulation for cooling, and can often be obtained for free (as discarded sign boards from elections, etc.).

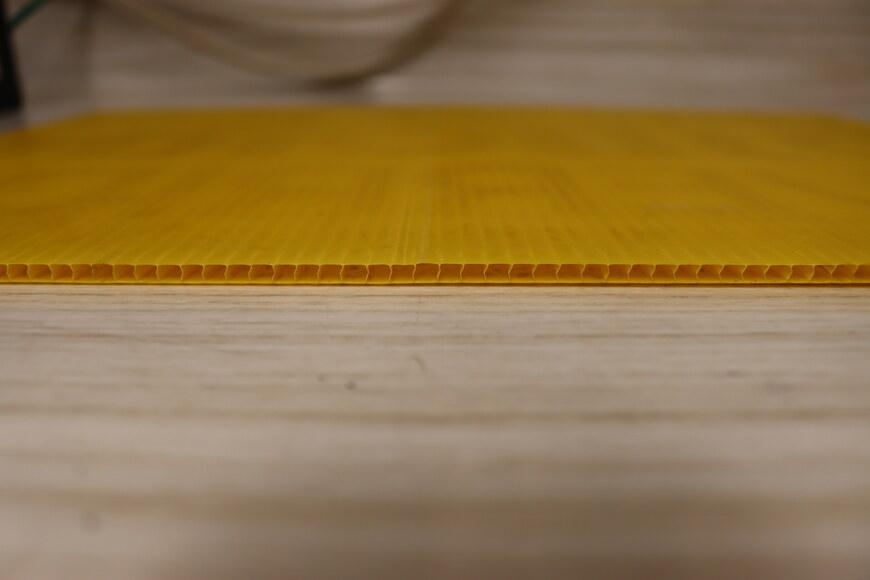
[picture p78: _attachments/IMG_2626_1751892504234263.JPG]
Side view of corrugated plastic
    

    *Side view of corrugated plastic.*

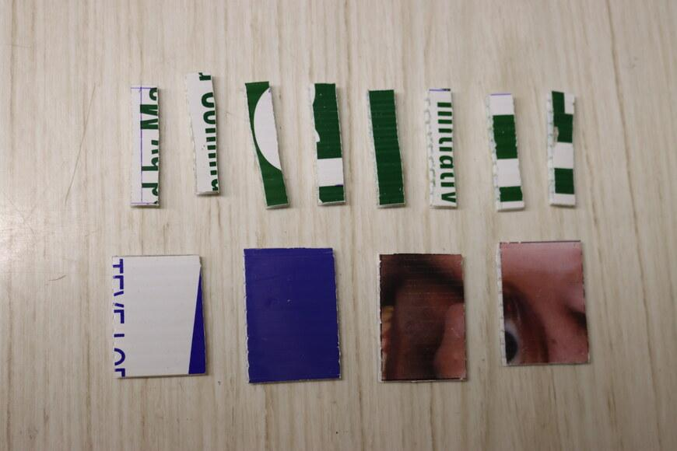
[picture p79: _attachments/IMG_2627_1751892504240076.JPG]
Eight 1 3/4" x 3/8" and four 1 3/4" x 1 1/4" spacers are needed for each cage
    

    *Eight 1 3/4" x 3/8" and four 1 3/4" x 1 1/4" spacers are needed for each cage.*

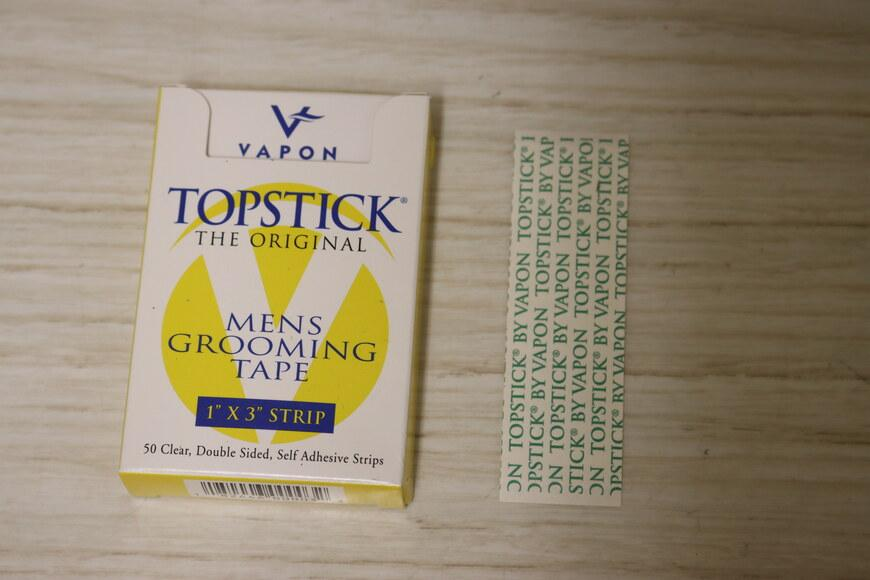
[picture p80: _attachments/IMG_2629_1751892504245609.JPG]
Use double-sided tape to affix the spacers to the bottom of the battery cage
    

    *Use double-sided tape to affix the spacers to the bottom of the battery cage.*

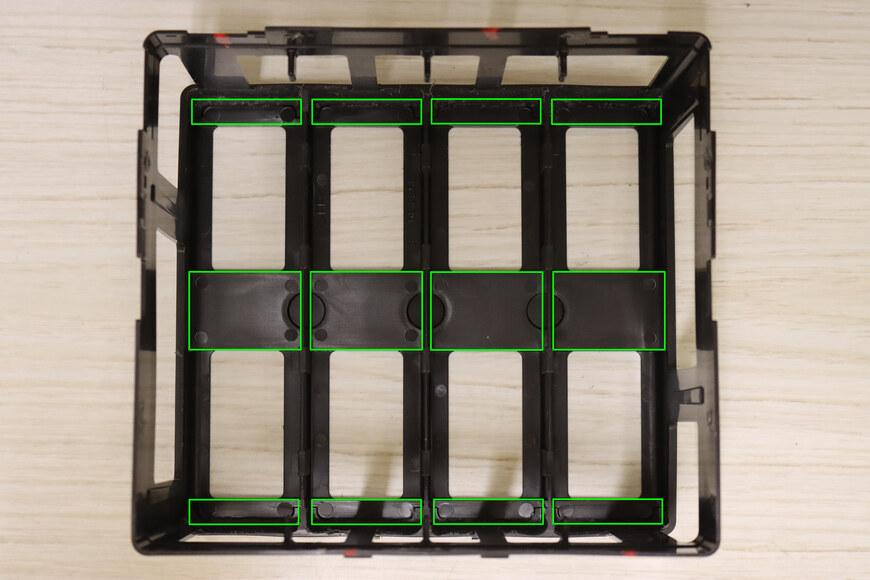
[picture p81: _attachments/battery_cage_spacer_locations_175189250425204.jpg]
Locations for spacers
    

    *Locations for spacers.*

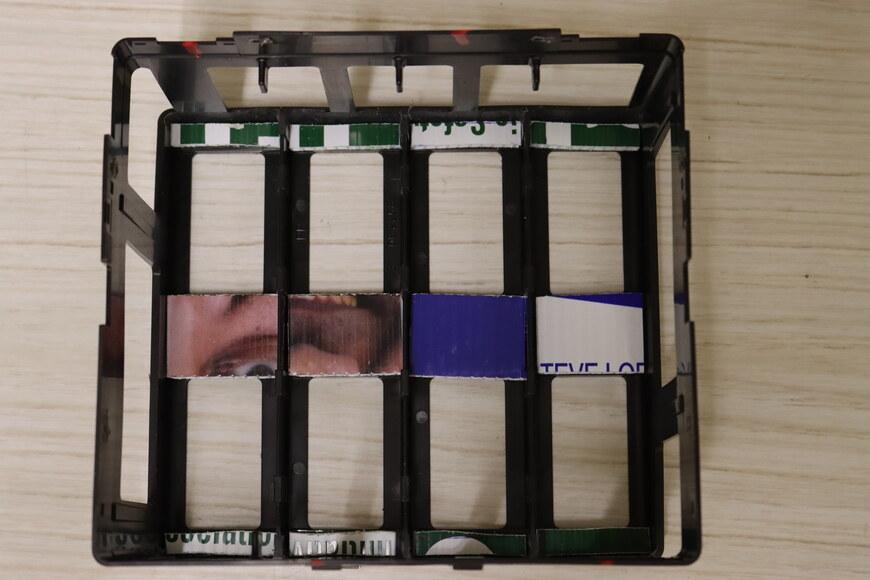
[picture p82: _attachments/IMG_2631_17518925042581701.JPG]
Spacers installed
    

    *Spacers installed.*

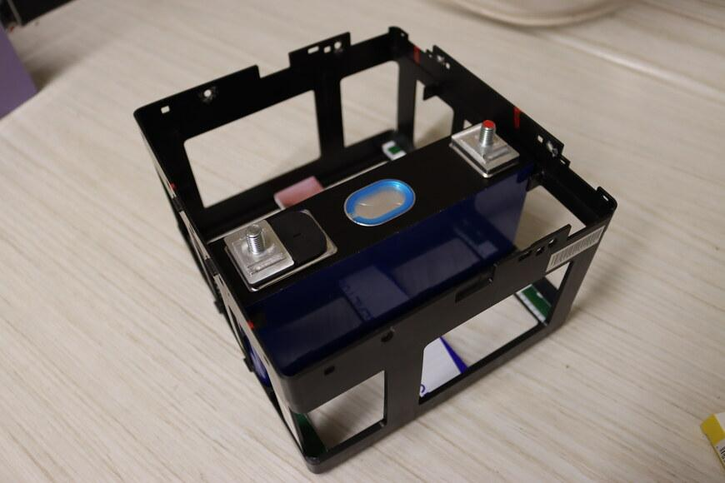
[picture p83: _attachments/IMG_2634_1751892504263669.JPG]
Battery installed on spacers
    

    *Battery installed on spacers.*

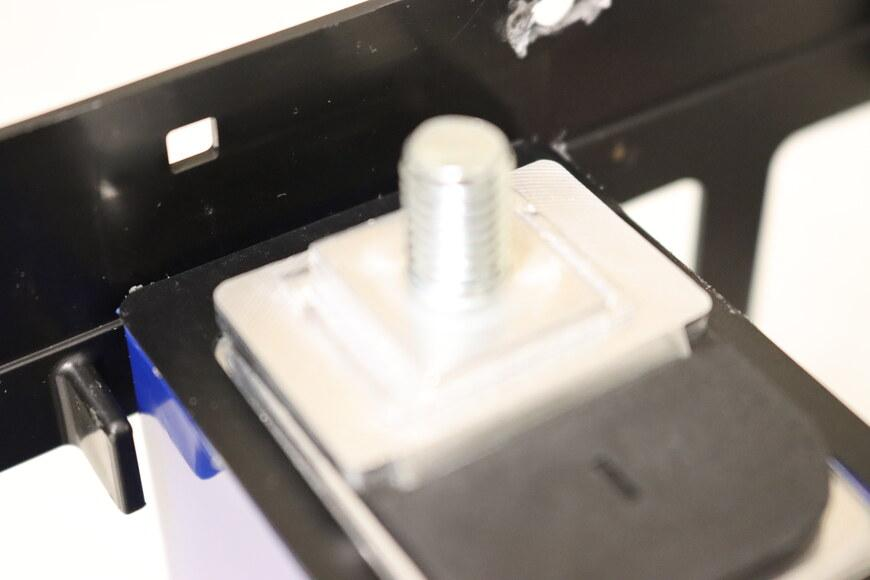
[picture p84: _attachments/IMG_2638_1751892504268196.JPG]
Battery now sits slightly above the line in the battery cage
    

    *Battery now sits slightly above the line in the battery cage.*

### New Battery Installation

1. Affix 4mm spacers between the batteries.

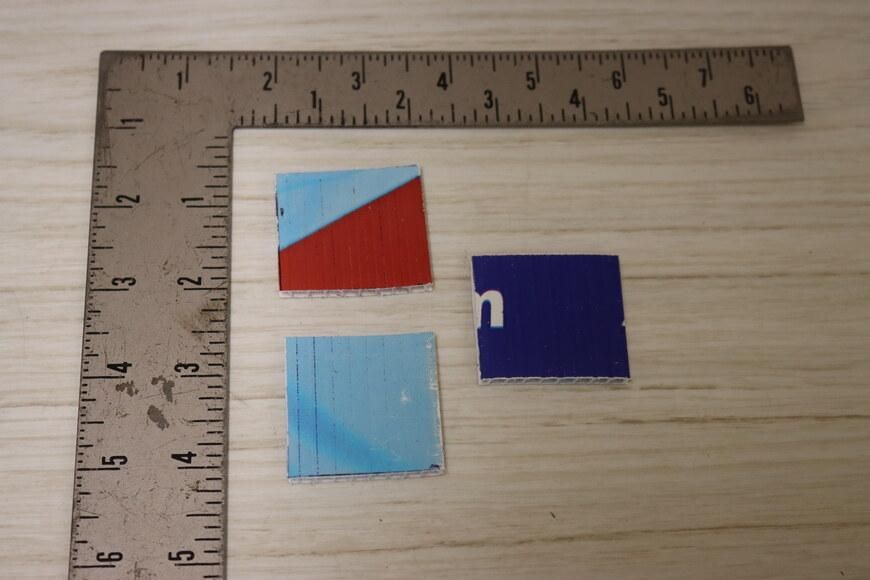
[picture p85: _attachments/IMG_2640_1751892504273325.JPG]
Three 1 1/2" x 1 1/2" spacers are needed for each set of four batteries
    

    *Three 1 1/2" x 1 1/2" spacers are needed for each set of four batteries.*

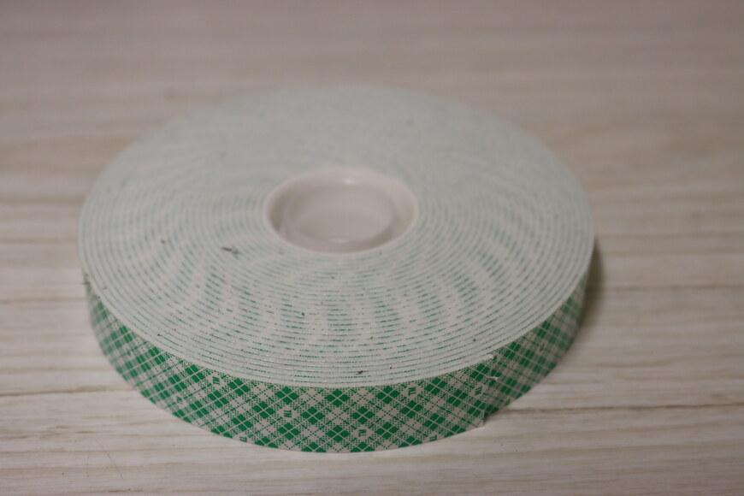
[picture p86: _attachments/IMG_2642_1751892504278489.JPG]
3/4" wide foam-backed double sided tape
    

    *3/4" wide foam-backed double sided tape.*

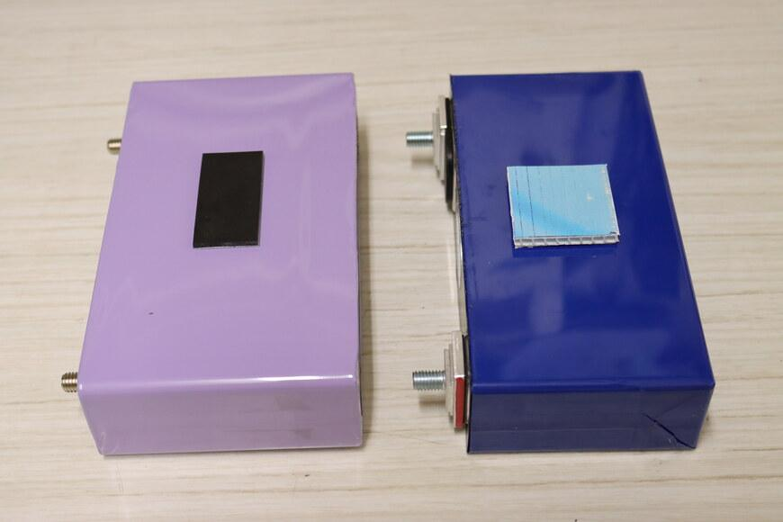
[picture p87: _attachments/IMG_2644_17518925042834911.JPG]
Shape of the spacer isn't critical. 1 1/2" x 1 1/2" was chosen as having approximately the same surface area (right) as the original spacer (left), while being a multiple of the 3/4" tape, which was the most conomical to purchase
    

    *Shape of the spacer isn't critical. 1 1/2" x 1 1/2" was chosen as having approximately the same surface area (right) as the original spacer (left), while being a multiple of the 3/4" tape, which was the most economical to purchase.*

2. Install the batteries in the battery cage. Pay attention to polarity.

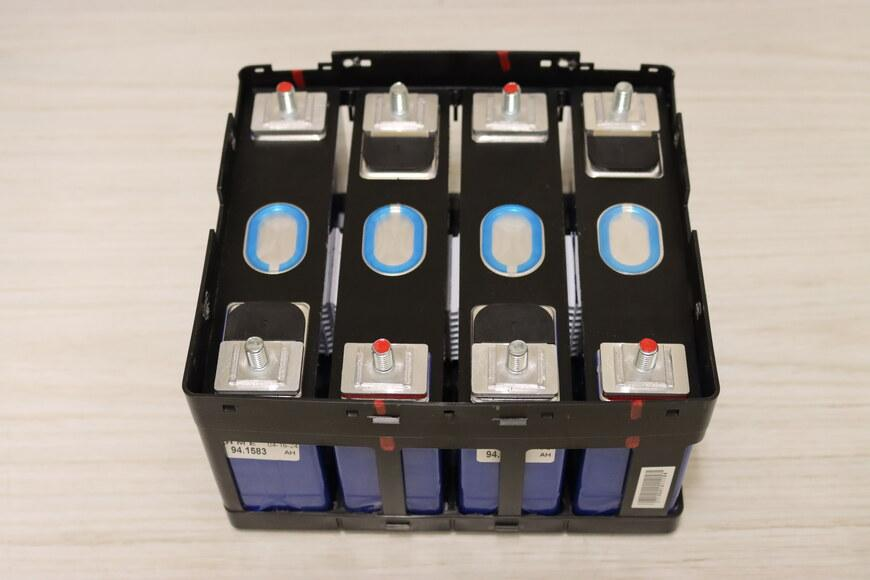
[picture p88: _attachments/IMG_2645_1751892504288478.JPG]
Ensure the batteries are fully seated and polarity is correct. Note the spacers between the batteries
    

    *Ensure the batteries are fully seated and polarity is correct. Note the spacers between the batteries.*

3. Fabricate jumpers to attach the CMU to the batteries.

    Note: These jumpers serve as both electrical conductors for measuring the battery voltage and thermal conductors for measuring the battery temperature.

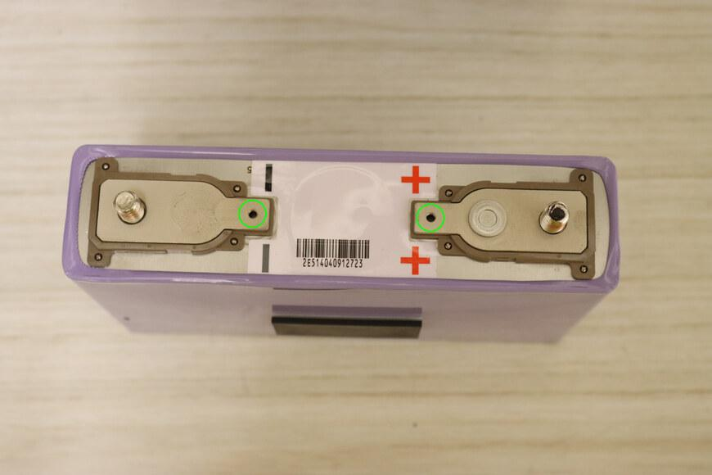
[picture p89: _attachments/lev50_mounting_holes_1751892856373943.jpg]
The LEV50s have an extra set of mounting holes, used to attach the CMU electrically and thermally to the battery
    

    *The LEV50s have an extra set of mounting holes, used to attach the CMU electrically and thermally to the battery.*

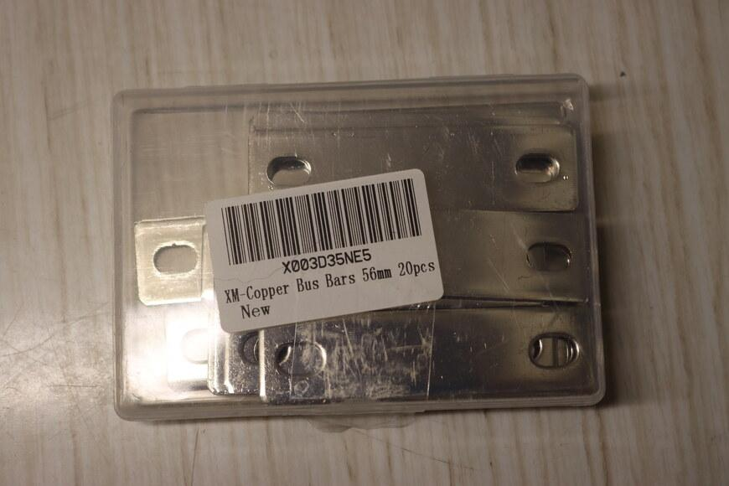
[picture p90: _attachments/IMG_2671_1751892504304107.JPG]
Bus bars were used to construct the jumpers. The 56mm length permitted the construction of a jumper, and a washer from the waste. The 6mm slots had to be ground out for the M8 terminals, as bus bars with 8mm lots weren't readily available
    

    *Bus bars were used to construct the jumpers. The 56mm length permitted the construction of a jumper, and a washer from the waste. The 6mm slots had to be ground out for the M8 terminals, as bus bars with 8mm slots weren't readily available.*

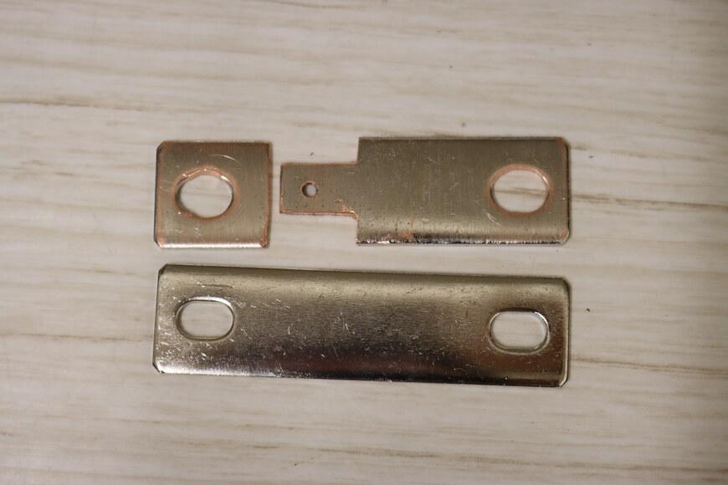
[picture p91: _attachments/IMG_2543_1751892504293611.JPG]
Jumpers and washers (top) were fabricated out bus bars (bottom). These were cut with a hack saw and then sanded to remove flashing and ensure good electrical contact for the high current application. The hole as tapped as an M3 x 0.5 to match the threads of the existing screws
    

    *Jumpers and washers (top) were fabricated out bus bars (bottom). These were cut with a hack saw and then sanded to remove flashing and ensure good electrical contact for the high current application. The hole was tapped as an M3 x 0.5 to match the threads of the existing screws.*

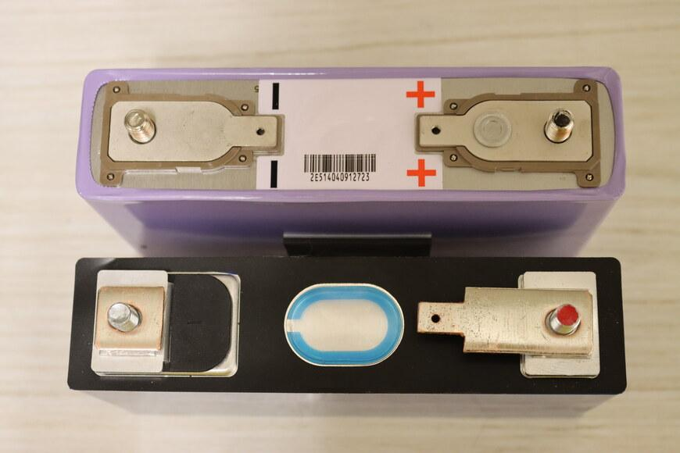
[picture p92: _attachments/IMG_2553_1751892504298835.JPG]
Jumper installed on the new battery (bottom) to provide the connection to the CMU. Old battery (top) shown for comparison. Washer also installed on the new battery as a spacer, so that both terminals are the ame height
    

    *Jumper installed on the new battery (bottom) to provide the connection to the CMU. Old battery (top) shown for comparison. Washer also installed on the new battery as a spacer, so that both terminals are the same height.*

### CMU and Bus Bar Installation

1. Install jumpers and washers on battery terminals.

    > [!WARNING]
    > Take care that the jumpers do not rotate and touch adjacent battery terminals, as this could cause a short circuit.

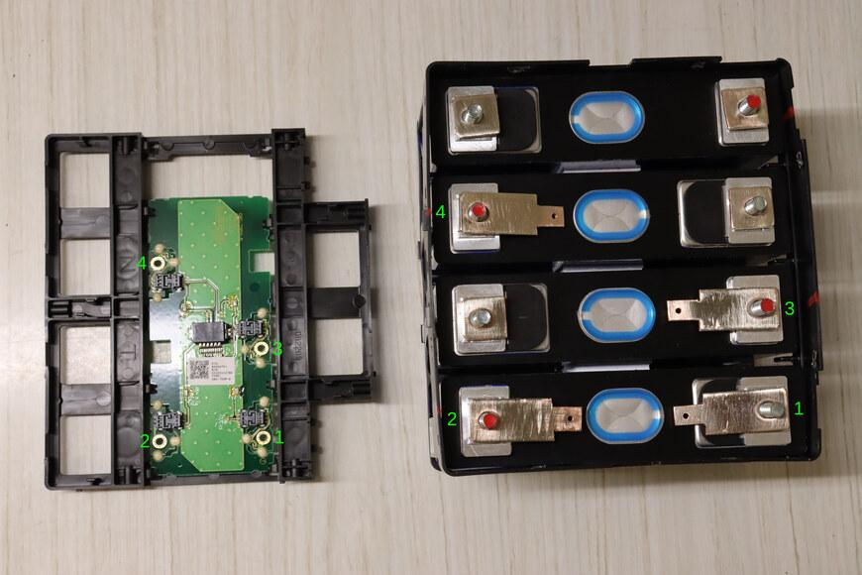
[picture p93: _attachments/installing_jumpers_1751892504328647.jpg]
Orient the CMU daughter board and battery cage based on the cut outs for the terminals. Add jumpers on the terminals that connect to the CMU board. Add washers on the remaining terminals
    

    *Orient the CMU daughter board and battery cage based on the cut outs for the terminals. Add jumpers on the terminals that connect to the CMU board. Add washers on the remaining terminals.*

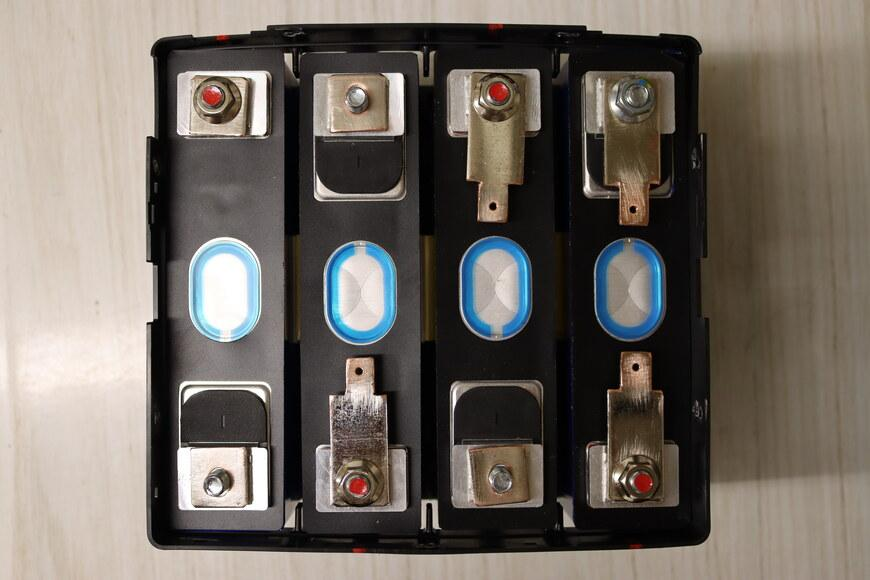
[picture p94: _attachments/IMG_2712_1751892504311129.JPG]
Tip: Nuts can be tightened against the jumpers temporarily to keep the jumpers from rotating and shorting to adjacent terminals when the webbing is installed in the subsequent step
    

    *Tip: Nuts can be tightened against the jumpers temporarily to keep the jumpers from rotating and shorting to adjacent terminals when the webbing is installed in the subsequent step.*

2. Install the plastic webbing and CMU on the battery cage.

    > [!WARNING]
    > Take care that the jumpers do not rotate and touch adjacent battery terminals and cause a short circuit during this process. Once the webbing is on, the jumpers will no longer be able to touch adjacent terminals.

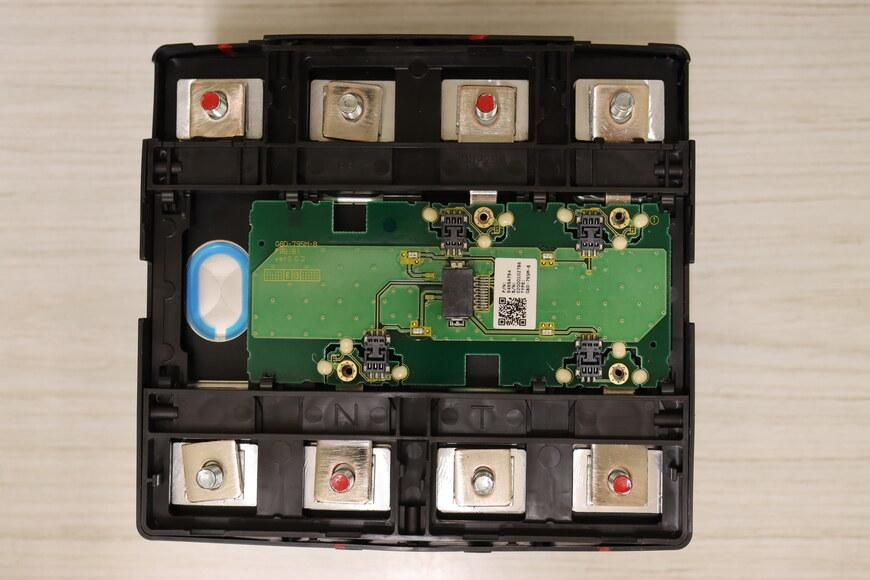
[picture p95: _attachments/IMG_2650_1751892504322616.JPG]
Plastic webbing with CMU daughter board installed on battery cage
    

    *Plastic webbing with CMU daughter board installed on battery cage.*

3. Align the jumpers with the holes in the CMU board and start the screws.

    > [!WARNING]
    > Do not tighten the screws yet to avoid transferring forces to the delicate board during the next steps of reassembly.

    > [!WARNING]
    > With the webbing positioned via the plastic positioning tabs, the top of the jumpers should align with the bottom of the CMU board. If not, it may be necessary to adjust the shimming of the batteries. Non-neutral positioning may result in breaking the board later when the screws are tightened.

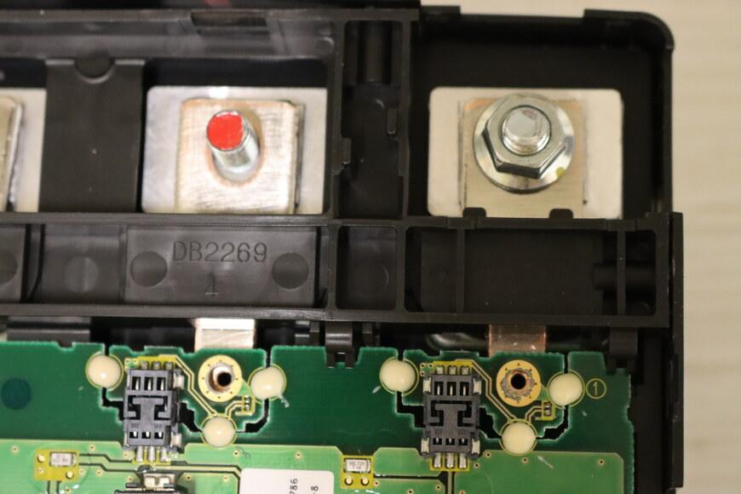
[picture p96: _attachments/IMG_2652_1751892504322809.JPG]
Align the threaded holes on the jumpers with the CMU board holes. A nut, no tighter than finger tight, can be used on the terminal to hold the jumper in place if necessary
    

    *Align the threaded holes on the jumpers with the CMU board holes. A nut, no tighter than finger tight, can be used on the terminal to hold the jumper in place if necessary.*

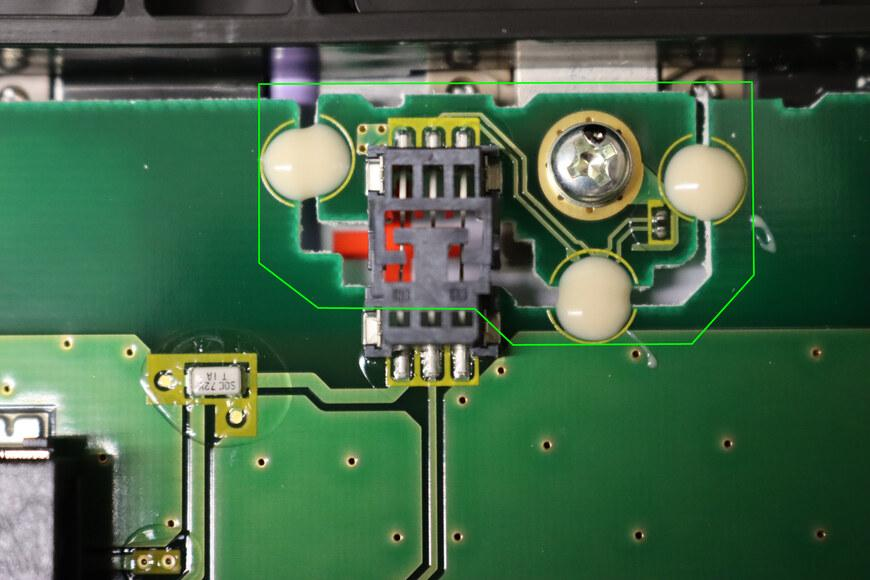
[picture p97: _attachments/circuit_board_flex_front_1751892504339487.jpg]
Floating tabs on the circuit board allow for slight, independent movement of the batteries from the board. These are delicate. Too much stress or movement and these will break
    

    *Floating tabs on the circuit board allow for slight, independent movement of the batteries from the board. These are delicate. Too much stress or movement and these will break. Shown here mounted to the original LEV 50.*

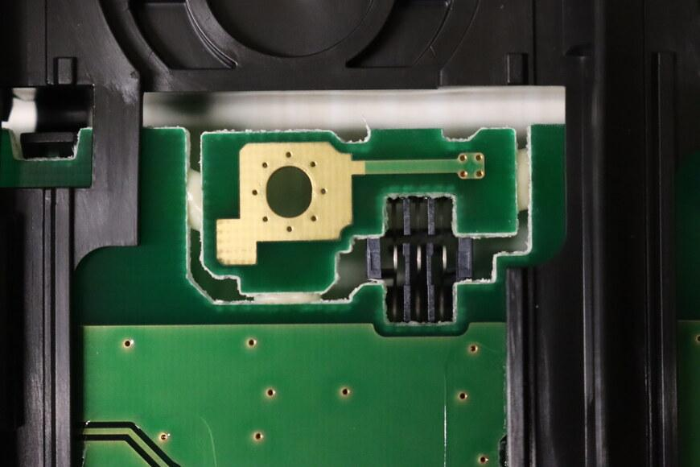
[picture p98: _attachments/IMG_2729_17518925043339531.JPG]
View of the floating tab from the back side of the circuit board (not visible at this point in assembly)
    

    *View of the floating tab from the back side of the circuit board (not visible at this point in assembly).*

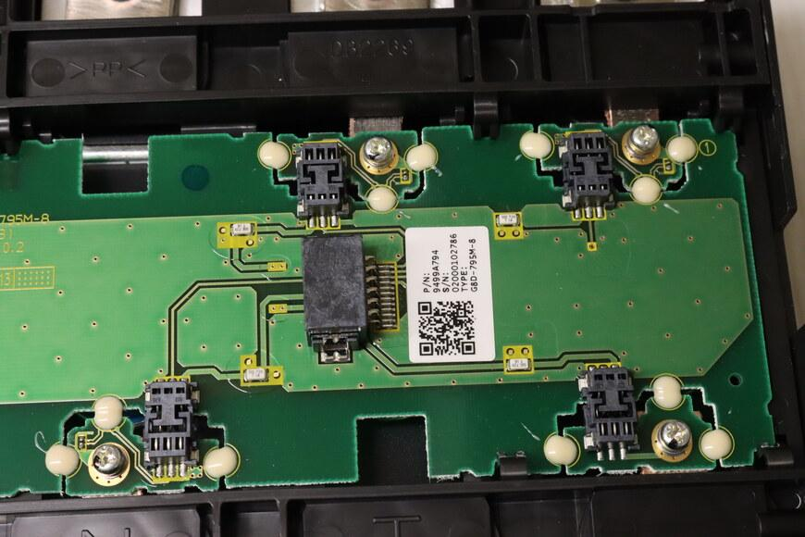
[picture p99: _attachments/IMG_2653_17518925043478029.JPG]
Screws installed but not tightened
    

    *Screws installed but not tightened.*

4. Install the three bus bars and 6 nuts; tighten to specification.

    > [!WARNING]
    > Do not tighten a nut on a jumper unless there is a bus bar installed to prevent the torque from transferring to the jumper and the delicate CMU board.

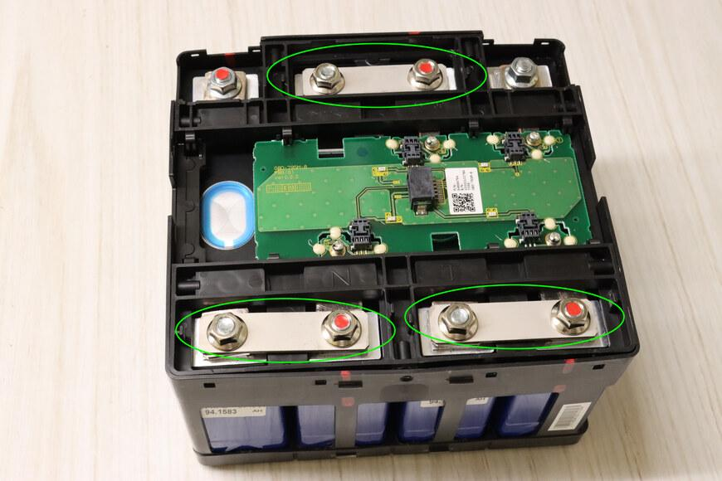
[picture p100: _attachments/installing_bus_bars_1751892504359585.jpg]
Install bus bars and nuts
    

    *Install bus bars and nuts.*

5. Tighten the CMU screws. Watch for the circuit board being stressed while tightening. Stop and adjust/realign if necessary to avoid breaking the delicate board.

    > [!WARNING]
    > Do not tighten a CMU screw unless the jumper is well-supported (bus bar and nut, or just nut) on the battery terminal end. Else, the jumper will tilt down and stress the CMU board. If adding a terminal nut directly on top of a jumper, tighten only to finger tight to avoid transferring a large torque to the CMU board via the jumper.

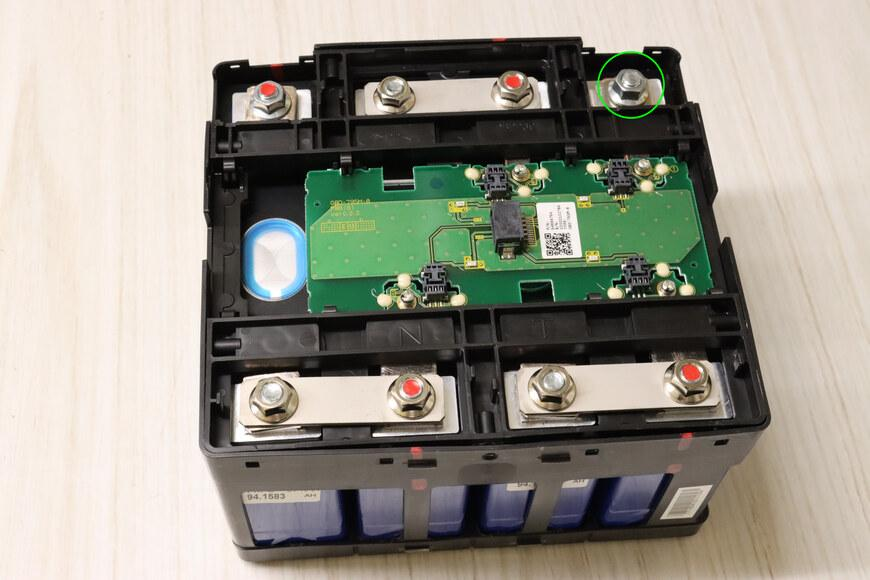
[picture p101: _attachments/tightening_screws_175189250436522.jpg]
Add a terminal nut (finger tight only) to the unsupported jumper to prevent the jumper from tilting down and stressing the circuit board while tightening the screw
    

    *Add a terminal nut (finger tight only) to the unsupported jumper to prevent the jumper from tilting down and stressing the circuit board while tightening the screw.*

### Testing and Verification

1. Measure the voltage of the submodule.

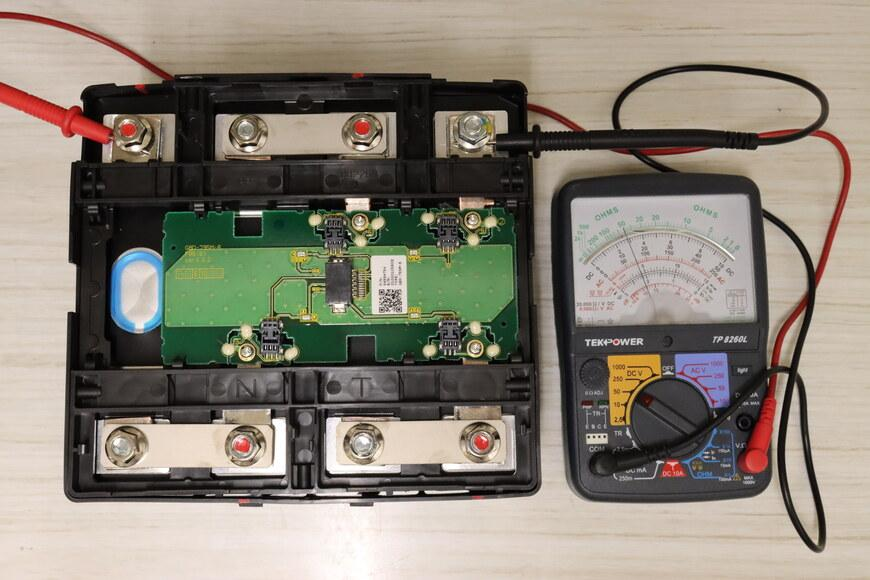
[picture p102: _attachments/IMG_2715_1751892504353921.JPG]
Voltage will depend on the state of charge of the cells, but should be approximately 4 * 3.7 volts = 14.8 volts
    

    *Voltage will depend on the state of charge of the cells, but should be approximately 4 * 3.7 volts = 14.8 volts.*

2. Rebuild the second submodule in the same fashion.

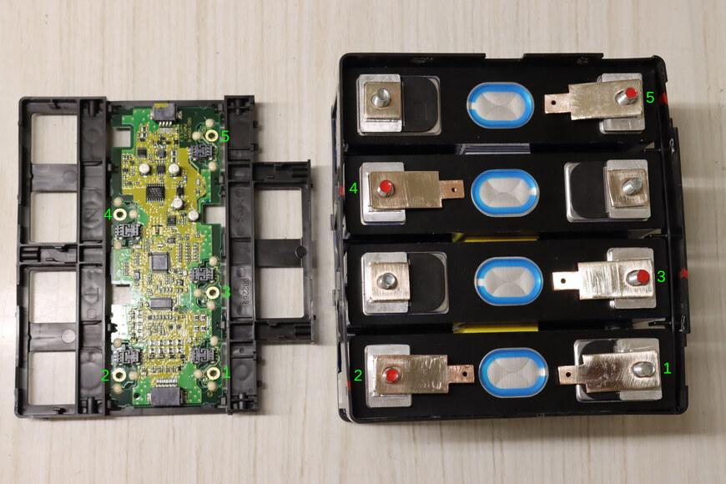
[picture p103: _attachments/cmu_installing_jumpers_17518925043717802.jpg]
Note that the CMU main board uses 5 jumpers instead of 4
    

    *Note that the CMU main board uses 5 jumpers instead of 4.*

### Final Assembly

1. Reinstall the bottom clam shell on both submodules.

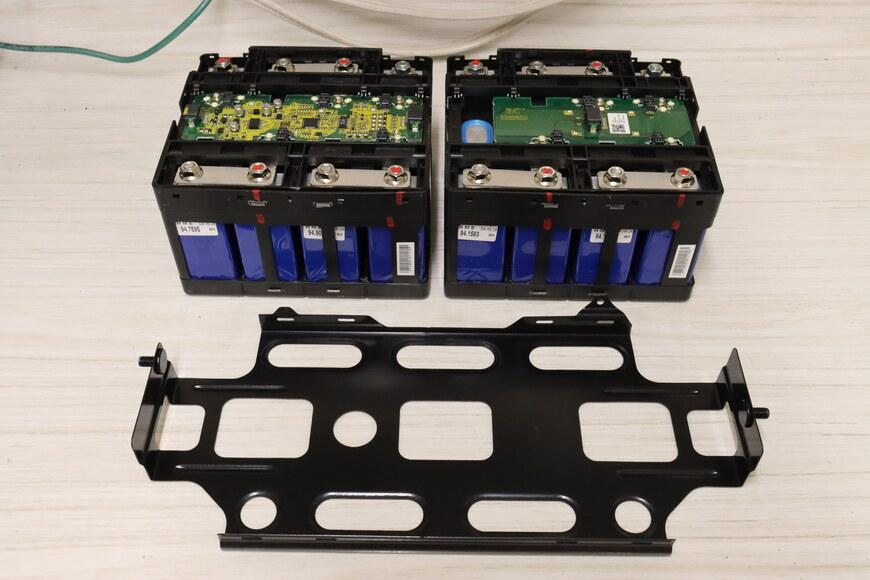
[picture p104: _attachments/IMG_2687_1751892504377661.JPG]
Note the positioning and orientation of the submodules and clam shell
    

    *Note the positioning and orientation of the submodules and clam shell.*

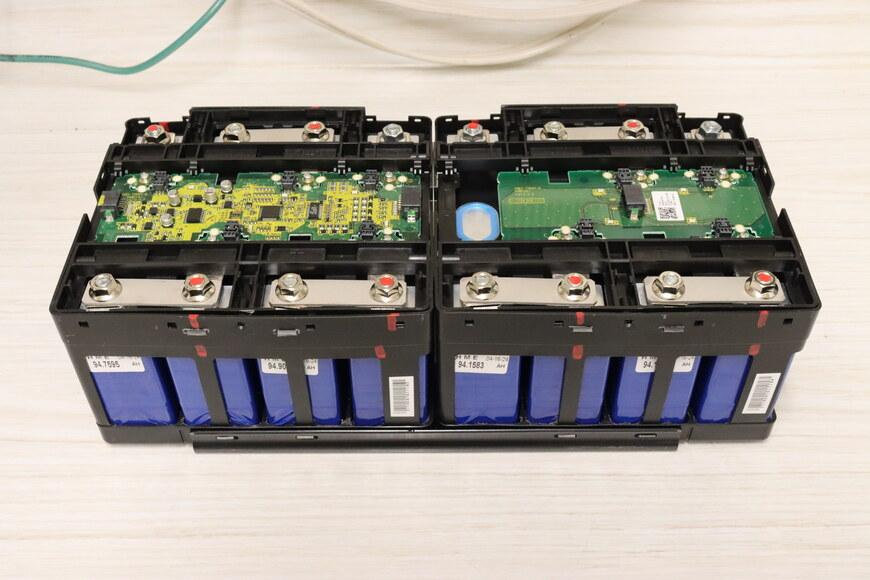
[picture p105: _attachments/IMG_2688_175189250439027.JPG]
Bottom clam shell installed
    

    *Bottom clam shell installed.*

2. Reinstall the cable between the CMU main board and daughter board.

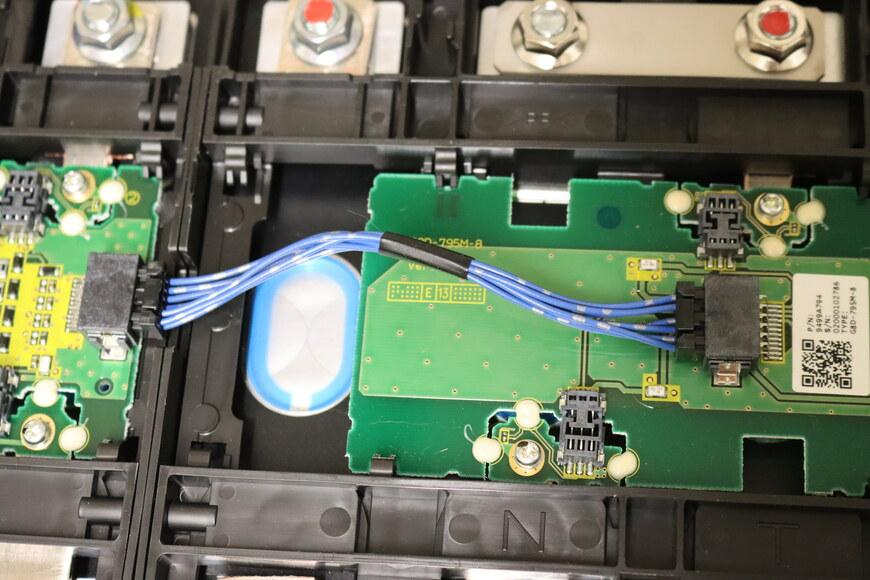
[picture p106: _attachments/IMG_2690_1751892504408801.JPG]
Installing the jumper cable
    

    *Installing the jumper cable.*

3. Reinstall the bus bar between the two submodules. Tighten nuts according to specification.

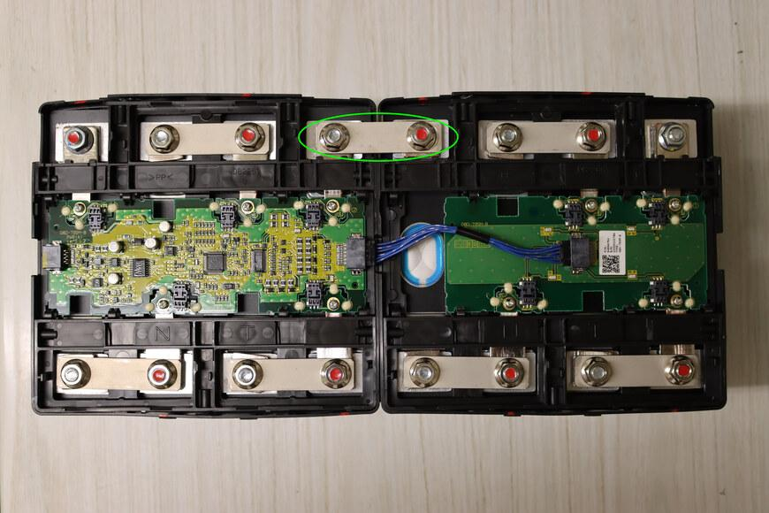
[picture p107: _attachments/bus_bar_between_submodules_17518925044083042.jpg]
Install the bus bar between the two submodules. Tighten nuts according to specification
    

    *Install the bus bar between the two submodules. Tighten nuts according to specification.*

4. Reinstall the plastic cover.

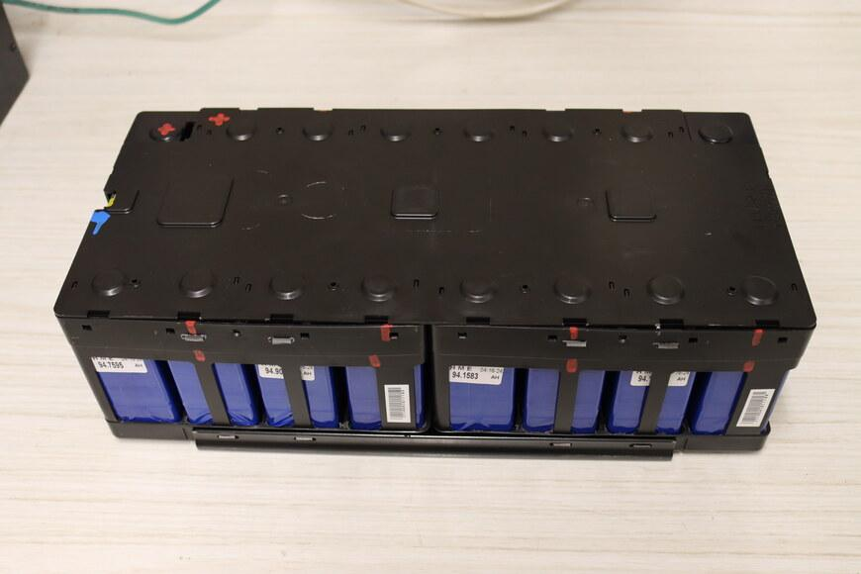
[picture p108: _attachments/IMG_2694_1751892504384494.JPG]
Plastic cover reinstalled
    

    *Plastic cover reinstalled.*

5. Check the voltage of the module.

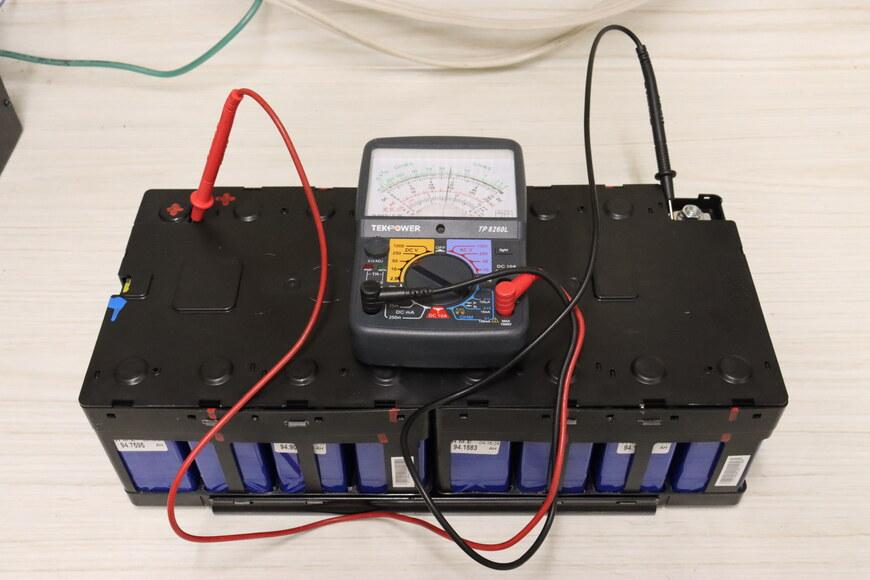
[picture p109: _attachments/IMG_2695_1751892504395612.JPG]
Voltage will depend on the state of charge of the batteries, but should be approximately 8 * 3.7 = 29.6 volts
    

    *Voltage will depend on the state of charge of the batteries, but should be approximately 8 * 3.7 = 29.6 volts.*

6. Reinstall the top metal clam shell.

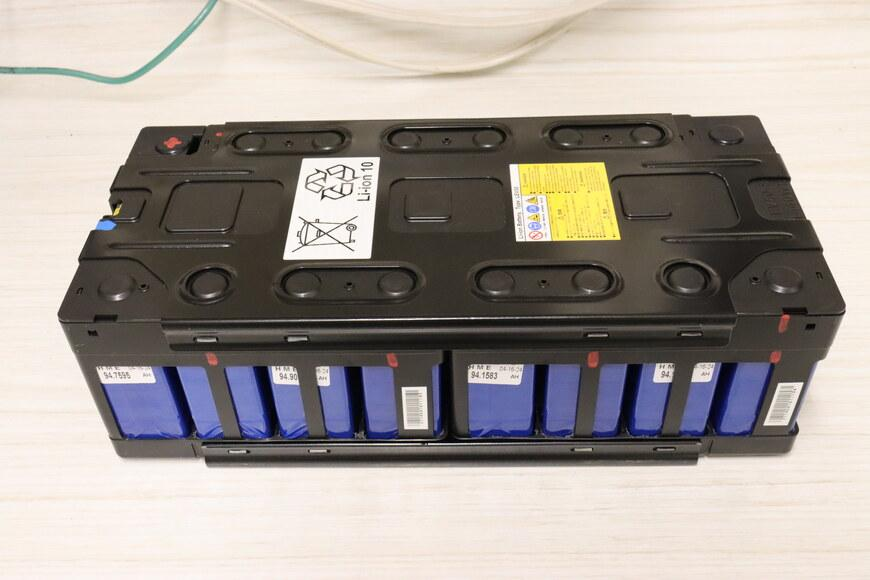
[picture p110: _attachments/IMG_2697_1751892504415261.JPG]
Top clam shell snapped onto the plastic tabs
    

    *Top clam shell snapped onto the plastic tabs.*

7. Reinstall the mounting brackets to hold the top and bottom clam shells together.

    Oversize holes result in the brackets having play on the studs, so it is recommended to not tighten the bracket nuts until fitting the module back into the pack.

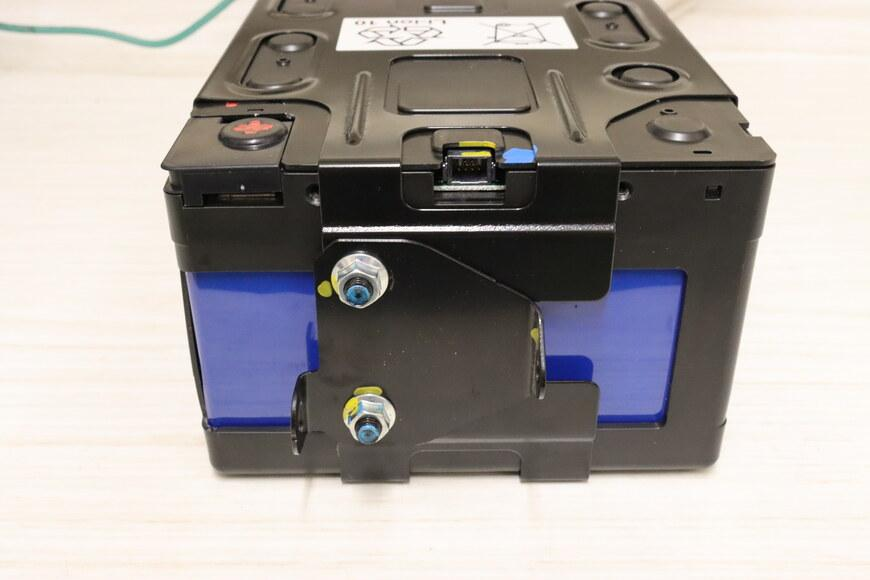
[picture p111: _attachments/IMG_2698_1751892504419869.JPG]
Left bracket (connector side) reinstalled
    

    *Left bracket (connector side) reinstalled.*

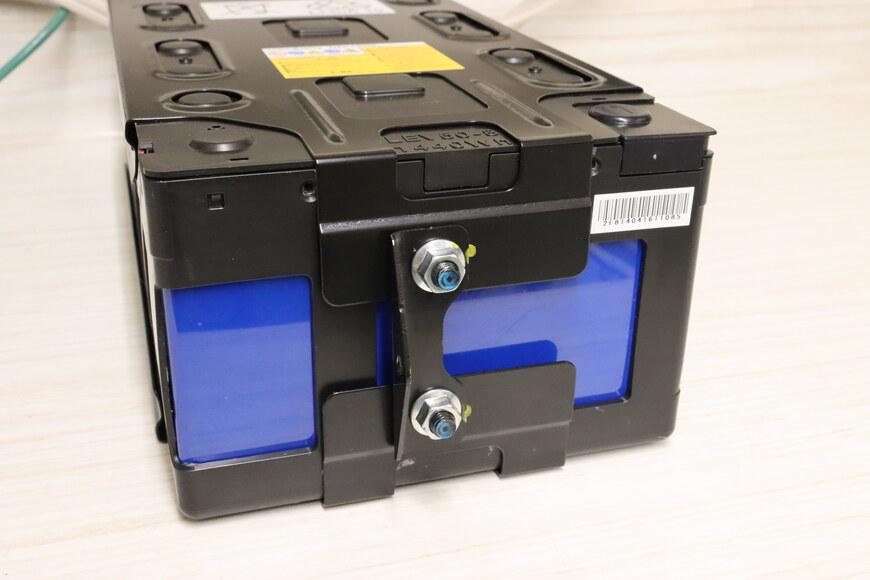
[picture p112: _attachments/IMG_2699_1751892504425451.JPG]
Right bracket reinstalled
    

    *Right bracket reinstalled.*

8. Reinstall the module in the pack, making sure to tighten the bracket nuts if they were left loose in the previous step.
