imiev-battery-upgrade/imiev-battery-upgrade/(commit log)

2024-12-21 add link to basic Arduino Can docs
2024-12-23 add warnings and battery notices
2024-12-23 glossary: add TPMS
    even if it's not battery related, still useful to be able to read the forum properly
2024-12-26 add cmu pic
    source: Mário Fernandes, Portugal, through https://www.diyelectriccar.com/threads/mitsubishi-i-miev-cmu-board-notes.200527/
2024-12-27 add battery terminal
2025-02-28 Update battery chemistries with CATL and SVOLT NMC cell details
    - Add detailed specifications for CATL 93Ah and SVOLT NMC-90F cells
    - Update Alibaba sources in README.md
    - Expand recommendation section with emerging cell alternatives
2025-06-16 Add STM32F105 CAN bridge sample code for i-MiEV battery upgrade
2025-07-07 added latest mitm instructions and stm32 link
2025-07-07 docs: add STM32 flashing resources to readme
2026-01-13 docs: add bonybrown's improved STM32 BMU MITM board to readme
